Kronnos2006/smart-plant-bot/docs/entrega-final/Smart_Plant_Bot_Presentacion.pptx

Smart Plant Bot

Un sistema que cuida tus plantas automáticamente

Proyecto Final - Ingeniería Mecatrónica
Universidad INVENIO

## Slide 2

¿Por qué nuestras plantas mueren?

Las plantas de interior necesitan:

💧 Agua en la cantidad correcta (no mucha, no poca)

☀️ La cantidad adecuada de luz

🌡️ Temperatura y humedad estables

⏰ Atención constante y rutina

## Slide 3

¿Qué es Smart Plant Bot?

Es un pequeño sistema "inteligente" que:

✓ Riega la planta automáticamente cuando lo necesita

✓ Verifica que hay agua en el tanque

✓ Mide temperatura, humedad y luz del ambiente

✓ Todo sin que tengas que hacer nada

## Slide 4

¿Cómo funciona?

Proceso simple:

1️⃣ El sensor de humedad revisa la tierra

2️⃣ Si está muy seca, enciende la bomba

3️⃣ El agua sube desde el tanque a la maceta

4️⃣ Cuando hay humedad, apaga la bomba

5️⃣ El sistema mide la luz y temperatura

## Slide 5

Los "ojos y oídos" del sistema

Sensor de humedad de la tierra

Detecta si la tierra está seca o mojada

Sensor de nivel del tanque

Avisa si el agua se acabó

Sensor de temperatura y humedad

Mide el ambiente donde está la planta

Sensor de luz

Verifica si hay suficiente iluminación

## Slide 6

El "cerebro" del sistema

Arduino UNO

Es un pequeño microprocesador que:

📊 Recibe información de todos los sensores

🧠 Decide automáticamente cuándo regar

⚡ Controla la bomba de agua

⚙️ Todo basado en reglas lógicas y seguras

Tiene protecciones para que nada se dañe

## Slide 7

¿Por qué es útil?

🌱 Tus plantas siempre tienen el agua que necesitan

⏰ No depende de que recuerdes regarlas

💰 Evita gastar agua innecesariamente

📱 Puedes monitorear las condiciones del ambiente

🏠 Ideal para apartamentos y espacios pequeños

🎓 Sistema educativo: aprendes cómo funcionan los sistemas automáticos

## Slide 8

Smart Plant Bot

Plantas felices, sin preocupaciones

Un proyecto que combina:
Ingeniería • Electrónica • Programación • Sostenibilidad

¿Preguntas?
