Kronnos2006/smart-plant-bot/docs/entrega-final/Proyecto_Final_INV2026_corregido.docx

UNIVERSIDAD INVENIO

Facultad de Ingeniería

Ingeniería en Mecatrónica

Smart Plant Bot: sistema automatizado de cuidado de plantas mediante riego por humedad de suelo, supervisión del nivel del tanque y monitoreo de variables ambientales

Proyecto Final

Elaborado por:

Héctor José Caldera Alfaro — UI-SC-2025-47

Kensy Jimena Castro Vásquez — UI-SC-2024-87

José Mario Molina Herrera — UI-SC-2025-21

María Fernanda Porras Ruiz — UI-SC-2024-68

Guanacaste, septiembre de 2026

# Dedicatoria

A las familias que sostienen económica y emocionalmente la permanencia en la carrera, y que rara vez aparecen en los documentos que hacen posibles. A quienes cultivan plantas en balcones, cocinas y pasillos de apartamentos pequeños, porque de esa costumbre salió la pregunta que originó este proyecto.

# Agradecimientos

A la Universidad INVENIO, por el acceso a los laboratorios de la sede Los Ángeles de Tilarán y a las bases de datos académicas empleadas en la revisión de literatura.

Al cuerpo docente de la carrera, por las observaciones que obligaron a recortar el alcance del prototipo hasta dejarlo en algo que efectivamente se podía terminar y sustentar dentro del trimestre.

A las personas compañeras de la carrera que revisaron los avances y señalaron incoherencias entre el circuito simulado y el texto que lo describía, varias de las cuales habrían llegado sin corregir a la versión final.

# Resumen

El cuidado de plantas de interior en viviendas y aulas depende de una atención constante que las rutinas de trabajo y estudio interrumpen con frecuencia. La irregularidad del riego, el agotamiento del depósito y la falta de monitoreo de las condiciones ambientales pueden provocar riego excesivo o insuficiente, desperdicio de agua y operación inadecuada del sistema de bombeo. Por ello, el proyecto propone el Smart Plant Bot, un sistema electrónico de bajo costo para entornos domésticos y educativos de Costa Rica. El sistema, gobernado por un microcontrolador Arduino Uno, integra un sensor capacitivo de humedad de suelo para decidir el riego, un sensor de flotador para bloquear la bomba cuando el nivel del tanque es insuficiente y sensores DHT22 y BH1750 para medir temperatura, humedad relativa e iluminancia. La propuesta se fundamenta en mecánica de fluidos, electrostática, hidrostática, principio de Arquímedes, fotometría, física de semiconductores y modelado mediante ecuaciones diferenciales ordinarias de primer orden. La validación se realizó mediante simulación del circuito y de la lógica de control en Proteus, debido a que la construcción física quedó fuera del alcance temporal del trimestre. Los resultados verifican la lógica de umbral con histéresis, la inhibición del riego por nivel insuficiente y el comportamiento de la etapa de potencia con sus protecciones, estableciendo una base técnica para la construcción y validación física posterior del prototipo.

Palabras clave: riego automático, sensor capacitivo de humedad, supervisión de nivel, monitoreo ambiental, sistema mecatrónico.

# Índice General

# Índice De Tablas

# Índice De Figuras

# Capítulo 1: El Problema Y Su Propósito

Este capítulo delimita la dificultad técnica que dio origen al Smart Plant Bot y fija el propósito del trabajo. Comienza por el tema y su ubicación dentro de la Ingeniería Mecatrónica, describe la situación problemática con sus causas y consecuencias, revisa cuatro antecedentes que sitúan la propuesta dentro de una línea de investigación existente, formula las preguntas que orientan el estudio y cierra con la justificación, los objetivos, la viabilidad y las consecuencias esperadas de la intervención.

## 1.1. Tema De La Investigación

La automatización del cuidado de plantas a pequeña escala se ha vuelto una línea de trabajo habitual dentro de la Ingeniería Mecatrónica, sostenida por dos motivos que conviene separar. El primero es el interés por reducir el consumo de agua y de energía mediante sistemas embebidos de bajo costo. El segundo es didáctico: un prototipo de este tipo obliga a integrar mecánica de fluidos, electrostática, fotometría y física de los semiconductores en un mismo objeto, de modo que los principios estudiados en los cursos de física, matemática y circuitos dejan de ser enunciados de pizarra y pasan a tener consecuencias medibles sobre un circuito que funciona o no funciona.

El valor práctico se concreta en el prototipo Smart Plant Bot, gobernado por una placa Arduino Uno. El sistema decide el riego a partir de un sensor capacitivo de humedad de suelo, condiciona esa decisión a la existencia de reserva en el tanque y adquiere la temperatura, la humedad relativa y la iluminancia mediante sensores ambientales. El resultado es una solución replicable para espacios domésticos y educativos, construida con componentes disponibles en el mercado nacional y sin necesidad de supervisión humana continua.

Pese a la oferta creciente de dispositivos comerciales para el cuidado automatizado de plantas, sigue habiendo un vacío en la integración de estas tres funciones dentro de un mismo prototipo de arquitectura abierta y precio accesible. Ese vacío es el que el proyecto ocupa, y de paso permite desarrollar competencias en el diseño de sistemas mecatrónicos integradores, un área con demanda creciente en el mercado laboral costarricense.

## 1.2. Planteamiento Del Problema

El cuidado de plantas de interior en viviendas urbanas y en aulas depende de una atención sostenida que las rutinas de trabajo y los períodos de ausencia interrumpen con regularidad. El riego es la tarea más sensible a esa irregularidad, porque tanto la falta prolongada de agua como el exceso repetido dañan las raíces, y porque quien cultiva rara vez dispone de una referencia objetiva del contenido de agua del sustrato. En su lugar recurre a una estimación visual o táctil poco confiable, cuyo error no es simétrico: la tendencia dominante es a regar de más, por precaución.

A esa dificultad se suma el agotamiento del depósito. Un sistema que riega de forma autónoma pero no sabe cuánta agua le queda termina accionando la bomba en vacío, situación que desgasta el diafragma y que, además, priva al motor del enfriamiento que el propio flujo le proporciona. La consecuencia no es solo la pérdida de la planta, sino la del actuador.

El tercer aspecto es la ausencia de información sobre el entorno inmediato. La temperatura, la humedad relativa del aire y la iluminancia condicionan la velocidad con la que el sustrato pierde agua, de modo que desconocerlas impide interpretar el comportamiento observado. Las alternativas comerciales que sí registran esas magnitudes suelen exigir conexión permanente a una red de datos, requisito que encarece el equipo y ata su funcionamiento a la disponibilidad del servicio.

La convergencia de los tres aspectos configura una brecha clara entre lo que ocurre y lo que debería ocurrir. El riego se aplica según la agenda de la persona y no según la necesidad del sustrato; la reserva de agua se agota sin aviso; las condiciones ambientales quedan sin registrar. Ninguna de las tres decisiones relevantes se apoya en una medición.

De lo anterior se desprende la pregunta problema: ¿cuál es la viabilidad técnica y funcional de una maceta inteligente controlada por un microcontrolador Arduino, que integre el riego automático por humedad de suelo, la supervisión del nivel de agua del tanque y el monitoreo de variables ambientales, para el cuidado de plantas en entornos domésticos y educativos de Costa Rica durante el período 2026?

## 1.3. Antecedentes De La Investigación

Se revisaron cuatro trabajos publicados entre 2023 y 2025, localizados en las bases de datos ScienceDirect y Dialnet, procedentes de Estados Unidos, Indonesia, Ecuador y México. El criterio de selección fue su vínculo directo con la automatización del riego mediante humedad de suelo y con el monitoreo ambiental gobernado por microcontroladores de bajo costo, que son los dos ejes centrales del presente proyecto. Ninguno de los cuatro supera los cinco años de antigüedad. Se presentan en orden cronológico, del más antiguo al más reciente.

Bierer (2023), investigador del Servicio de Investigación Agrícola del Departamento de Agricultura de los Estados Unidos, con sede en Kearneysville, Virginia Occidental, publicó en la revista HardwareX el artículo titulado "Development of an open-source soil water potential management system for horticultural applications, Open_Irr", cuyo objetivo consistió en desarrollar una plataforma abierta y económica capaz de medir el estado hídrico del suelo y de ejecutar riegos de manera automática, sin exigir conocimientos de programación a la persona usuaria. El autor concluyó que el sistema cumplía ambas funciones a un costo competitivo frente a los equipos comerciales cerrados disponibles en el mercado hortícola.

En cuanto al enfoque, la investigación fue cuantitativa y de tipo aplicado, con un alcance validatorio centrado en el diseño, el ensamblaje y la prueba de un prototipo funcional. La unidad de análisis fue el propio prototipo y no un conjunto de personas, razón por la cual el estudio no reporta muestreo probabilístico ni población estadística. La validación se ejecutó durante abril de 2022 en un invernadero climatizado, sobre sesenta portainjertos de manzano distribuidos entre cinco nodos de medición y una puerta de enlace, con seiscientos cincuenta y cinco pares de lecturas contrastados frente a un lector comercial de referencia.

Este antecedente se relaciona de manera directa con el planteamiento del problema del presente proyecto, en tanto demuestra que un microcontrolador económico puede leer el estado hídrico del sustrato y accionar un actuador cuando la medición desciende por debajo de un umbral definido, que es exactamente el principio de funcionamiento de la maceta inteligente propuesta. La correspondencia alcanza incluso el nivel del componente, pues la etapa de potencia de Open_Irr emplea un transistor de efecto de campo FQP30N06 acompañado de una resistencia de polarización a tierra, topología que este proyecto retoma en su primer objetivo específico.

El aporte teórico de este antecedente reside en sustentar la relación entre el estado hídrico del sustrato y la decisión de riego, relación que constituye el fundamento del control por umbral desarrollado en el marco teórico. El aporte práctico consiste en demostrar que una arquitectura abierta y de bajo costo automatiza el riego sin depender de equipos comerciales cerrados, lo cual respalda la viabilidad económica de la propuesta. El aporte metodológico procede del procedimiento de contrastar las lecturas del prototipo frente a un instrumento de referencia y de cuantificar la concordancia obtenida, procedimiento replicable durante la fase de validación de este trabajo.

Setiawan et al. (2023), investigadores de la Universidad Bina Nusantara, con sede en Yakarta, Indonesia, publicaron en la revista Procedia Computer Science el artículo titulado "Smart Plant Watering and Lighting System to Enhance Plant Growth Using Internet of Things", cuyo objetivo consistió en proponer un sistema inteligente de cuidado vegetal que integrara el riego y la iluminación complementaria mediante sensores conectados a una placa Arduino. Los autores concluyeron que el riego decidido a partir de la humedad del sustrato y de la intensidad lumínica operó de forma automática y sostenida durante todo el período de ensayo, sin requerir intervención manual.

Metodológicamente, el estudio correspondió a un desarrollo experimental de enfoque cuantitativo y de tipo aplicado, con un alcance comparativo, dividido en una fase de diseño de hardware y otra de diseño de software. La unidad de análisis estuvo constituida por el prototipo junto con las plantas cultivadas, de modo que no se aplicó muestreo probabilístico ni se definió una población estadística. Durante cuatro semanas se compararon las alturas alcanzadas por dos especies vegetales sometidas a riego automático y a riego manual, y se registraron de forma tabulada el contenido de agua del suelo, la intensidad lumínica y el estado de los actuadores.

La relación de este antecedente con los objetivos específicos del presente proyecto es directa, puesto que demuestra que una sola placa Arduino puede integrar la lectura simultánea de temperatura, humedad relativa, humedad de suelo e intensidad lumínica, que son precisamente las variables contempladas en el segundo objetivo específico de diagnóstico. El estudio emplea además un sensor equivalente al DHT22 seleccionado para esta propuesta y fija un umbral de humedad de suelo del sesenta por ciento para accionar la bomba, criterio que orienta la definición preliminar de los umbrales de activación del prototipo.

El aporte teórico de este trabajo consiste en fundamentar los rangos favorables para el crecimiento vegetal, con una temperatura comprendida entre quince y treinta grados Celsius y una humedad relativa situada entre sesenta y ochenta por ciento, valores que el presente proyecto adopta como referencia de interpretación. El aporte práctico se evidencia en la mayor altura alcanzada por las plantas bajo riego automatizado frente al manual. El aporte metodológico proviene del registro tabulado y periódico de las lecturas de sensores y del estado de los actuadores, formato que este proyecto reproduce durante la verificación funcional del sistema.

Potosí Carvajal et al. (2024), investigadores de la Universidad Laica Eloy Alfaro de Manabí, sede El Carmen, Ecuador, publicaron en la Revista Ciencia UNEMI el artículo titulado "Sistema de tiempo real para el riego en la finca Carmen Torres", cuyo objetivo consistió en elaborar y optimizar un sistema de riego automatizado en tiempo real para el cultivo de plátano, gobernado por un microcontrolador ESP32 y supervisado desde un sitio web que mostraba la humedad del suelo. Los autores concluyeron que la automatización redujo de manera apreciable las labores manuales de la finca, sin representar un costo elevado para la unidad productiva.

El estudio adoptó un enfoque cualitativo y un tipo de investigación aplicada, apoyado en el método analítico-sintético, con un alcance descriptivo centrado en diseñar y probar un prototipo dentro de un caso real. La población estuvo integrada por las personas trabajadoras de la finca, de las cuales se consultaron dos mediante entrevista: una perteneciente al personal administrativo y otra encargada directamente del riego. El muestreo fue de tipo no probabilístico e intencional, y se emplearon como técnicas la entrevista, la observación sistemática y una lista de cotejo destinada a verificar la infraestructura disponible.

Este antecedente se vincula sobre todo con la justificación del presente proyecto, dado que documenta un beneficio concreto y verificable para quienes ejecutaban el riego de forma manual: la liberación de una tarea repetitiva que interrumpía el resto de sus actividades cotidianas. El costo total del sistema, cercano a ciento noventa dólares estadounidenses, confirma que este tipo de solución se mantiene dentro de un intervalo económicamente accesible, argumento que sostiene tanto la relevancia social como la viabilidad declaradas para la maceta inteligente en los apartados siguientes de este capítulo.

El aporte teórico reside en el concepto de sistema en tiempo real aplicado al riego, según el cual una respuesta tardía pierde utilidad práctica, lo que justifica el muestreo continuo de las variables adoptado en esta propuesta. El aporte práctico consiste en demostrar que una placa de bajo costo gobierna una bomba mediante una etapa de conmutación sencilla, sin recurrir a controladores industriales. El aporte metodológico corresponde al empleo de una lista de cotejo para verificar la presencia y el estado de los componentes, instrumento que este proyecto adapta bajo la forma de la ficha de registro técnico descrita en el marco metodológico.

Jiménez (2025), investigador del Instituto Tecnológico Superior de Escárcega, ubicado en Campeche, México, publicó en Latam: Revista Latinoamericana de Ciencias Sociales y Humanidades el artículo titulado "Automatización del riego en un invernadero para cultivo de hortalizas de traspatio", cuyo objetivo consistió en desarrollar y evaluar un sistema automatizado con Arduino y sensores de humedad para optimizar el consumo de agua y mejorar el rendimiento frente al método tradicional. El autor concluyó que la automatización favorece una agricultura más eficiente y económicamente viable para las personas productoras de pequeña escala.

La investigación fue de tipo aplicada, con enfoque cuantitativo y diseño experimental, sustentada en la comparación entre dos áreas de cultivo de características similares sometidas a manejos distintos. La unidad de análisis estuvo constituida por dichas áreas de cultivo y no por un conjunto de personas, razón por la cual el estudio no reporta muestreo probabilístico ni población estadística. El alcance fue comparativo y se extendió durante treinta días, período en el que se midieron el consumo de agua, la frecuencia y la duración de cada riego, el crecimiento vegetal alcanzado y el tiempo dedicado a la supervisión del cultivo.

La relación de este antecedente con el primer objetivo específico del presente proyecto es directa, puesto que demuestra que un umbral de humedad definido distribuye el agua de manera más uniforme a lo largo del sustrato que el riego aplicado según el criterio de la persona cuidadora. La escala de traspatio en la que se desarrolló el estudio coincide además con los ámbitos doméstico y educativo delimitados en el planteamiento del problema de este trabajo, lo que refuerza la pertinencia de sostener el enfoque de pequeña escala frente a soluciones concebidas para agricultura extensiva.

El aporte teórico de este antecedente consiste en relacionar la uniformidad de la humedad del sustrato con el desarrollo vegetal alcanzado, relación que fundamenta la conveniencia del control por umbral frente al riego programado por tiempo. El aporte práctico se refleja en el ahorro de agua del treinta y cinco por ciento registrado y en la reducción a la mitad del tiempo dedicado a la supervisión del cultivo. El aporte metodológico corresponde al diseño comparativo entre el manejo automatizado y el tradicional, esquema que este proyecto podría replicar en una fase posterior de validación con el prototipo ya construido.

Los cuatro antecedentes revisados, procedentes de instituciones de Estados Unidos, Indonesia, Ecuador y México y publicados entre 2023 y 2025, describen en conjunto una línea de desarrollo tecnológico coherente. Bierer (2023) establece que una plataforma abierta y económica basta para automatizar el riego mediante umbrales de humedad de suelo. Setiawan et al. (2023) amplían ese alcance hacia el monitoreo simultáneo de temperatura, humedad relativa e iluminancia. Potosí Carvajal et al. (2024) trasladan el control en tiempo real a un caso productivo con costo verificado, y Jiménez (2025) cierra la línea comparando el manejo automatizado frente al manual y cuantificando el ahorro hídrico obtenido.

La escogencia de estos cuatro trabajos responde a que cada uno respalda un componente distinto de la presente propuesta: Bierer confirma la viabilidad técnica del riego por umbral y aporta la topología de la etapa de potencia; Setiawan et al. sustentan el diagnóstico de las variables ambientales y sus rangos de referencia; Potosí Carvajal et al. respaldan el beneficio social y el costo accesible; y Jiménez ofrece el criterio de comparación frente al manejo manual. Ninguno de los cuatro incorpora, sin embargo, la supervisión del nivel del depósito como condición que habilita el riego, y ese es precisamente el vacío que el Smart Plant Bot busca ocupar.

## 1.4. Preguntas De Investigación

Actualmente el cuidado de las plantas de interior en espacios domésticos y educativos se realiza, en la mayoría de los casos, de manera manual e intuitiva, sin herramientas que permitan medir de forma objetiva las variables que determinan su desarrollo, como la humedad del suelo, la luz que recibe o la temperatura del ambiente. Esa situación provoca que las decisiones sobre el riego y sobre la evaluación general del estado de la planta dependan casi por completo de la percepción de la persona cuidadora, lo cual aumenta la probabilidad de errores en el manejo cotidiano.

Entre las causas principales de esta situación se encuentra la falta de tiempo y de conocimientos técnicos de las personas encargadas del cuidado, quienes generalmente no cuentan con la disponibilidad necesaria para vigilar de forma constante las condiciones del ambiente ni para revisar de manera periódica cuánta agua queda en el depósito. A esto se suma el desconocimiento generalizado sobre los rangos adecuados de humedad, de luz y de nutrientes que requiere cada tipo de planta, lo cual conduce con frecuencia a prácticas de riego excesivo o insuficiente.

Otra causa relevante se relaciona con la oferta actual de dispositivos comerciales para el cuidado automatizado de plantas, que tiende a concentrarse en una sola función específica, ya sea el riego o la iluminación, sin integrar dentro de un mismo sistema el monitoreo de las condiciones del ambiente junto con la vigilancia de la reserva de agua disponible. A esto se agrega que los productos que sí reúnen varias funciones suelen tener un precio elevado, lo cual limita su acceso al estudiantado, a las personas aficionadas a la jardinería y a quienes disponen de recursos económicos moderados.

Como consecuencia de lo anterior, resulta común observar una alta tasa de deterioro o de muerte de plantas de interior, así como un uso ineficiente del agua destinada al riego, producto de decisiones basadas en la apreciación de la persona y no en mediciones reales de las condiciones del suelo y del ambiente. Esta situación no solo afecta el bienestar de las plantas, sino que además representa una oportunidad desaprovechada para desarrollar competencias tecnológicas dentro de la población estudiantil vinculada a la carrera de Ingeniería Mecatrónica.

De sostenerse esta situación sin ninguna intervención, es previsible que el cuidado de las plantas continúe dependiendo del criterio y del tiempo disponible de las personas cuidadoras, lo cual mantendrá elevadas tanto las tasas de pérdida de plantas como el desperdicio de agua en los hogares y en los espacios educativos donde se practica la jardinería de manera informal. A mediano plazo se dificultará además que el estudiantado relacione los contenidos de física con problemas cotidianos mediante un sistema que pueda medirse y observarse de forma directa.

Asimismo, si no se desarrollan alternativas tecnológicas accesibles, se mantendrá la dependencia respecto de dispositivos comerciales importados y de costo elevado, lo cual restringe el acceso de la población estudiantil y de las personas con recursos limitados a soluciones integrales de automatización. Esa dependencia retrasa además el desarrollo de capacidades locales en el diseño de sistemas mecatrónicos para la agricultura urbana, así como la posibilidad de construir prototipos propios, documentados, reparables y adaptados a las condiciones específicas de Costa Rica.

El presente proyecto se limita al contexto de los espacios domésticos y educativos costarricenses, y contempla como caso piloto su implementación dentro de los laboratorios de la Universidad INVENIO, sede Los Ángeles de Tilarán, desde donde se proyecta como una solución replicable en hogares, oficinas y pequeños proyectos de jardinería educativa de la región.

Con base en lo anterior, las preguntas que orientan la investigación se derivan de manera directa de los objetivos específicos formulados en el apartado 1.6.2 y se enuncian de la siguiente manera:

- ¿Cuáles son los requerimientos técnicos y funcionales del riego automático por humedad de suelo y de la supervisión del nivel de agua del tanque, incluyendo los parámetros de riego, la configuración de sensores de nivel y las condiciones de seguridad eléctrica de la conmutación?
- ¿Qué variables del ambiente resultan más relevantes para estimar el bienestar de la planta y con qué sensores conviene medirlas?
- ¿Cómo debe diseñarse la arquitectura funcional, eléctrica y mecánica que integre los tres subsistemas sobre una misma plataforma de control?
- ¿De qué manera puede validarse el funcionamiento del prototipo dentro de los límites de tiempo del trimestre académico?

## 1.5. Justificación De La Investigación

La propuesta ofrece una solución integral, replicable y de bajo costo para el cuidado de plantas en espacios domésticos y educativos. A diferencia de los dispositivos comerciales, que se concentran en el riego o en la iluminación, integra el riego por humedad de suelo, la vigilancia del nivel de agua y el monitoreo del ambiente, lo cual amplía tanto su utilidad práctica como su valor pedagógico para el estudiantado de Ingeniería Mecatrónica.

La automatización del riego a partir de una medición directa del sustrato sustituye una apreciación subjetiva por un criterio que puede cuantificarse, y la entrega de agua en eventos de duración acotada limita el consumo frente a la aplicación manual, habitualmente generosa por precaución. La vigilancia del depósito no es un agregado informativo: cumple una función de protección del actuador, ya que impide que la bomba trabaje en seco.

La decisión de mantener el control principal de forma local es un criterio de diseño deliberado y no una carencia. La lógica de riego no depende de una red, de un servicio contratado ni de credenciales de acceso, con la reducción de costo y de puntos de falla que eso implica. El conjunto sigue operando con normalidad ante cualquier interrupción del servicio de comunicaciones de la vivienda.

En cuanto a relevancia social, el proyecto beneficia a estudiantes, a personas aficionadas a la jardinería y a usuarios domésticos con poco tiempo. Las instituciones educativas pueden emplearlo como recurso didáctico para aplicar física, electrónica y programación a la agricultura urbana. Y en cuanto a trascendencia, la propuesta sienta bases para desarrollos posteriores dentro de la carrera, orientados a la agricultura urbana automatizada y al fortalecimiento de competencias en Internet de las Cosas aplicado a la física y la electrónica.

## 1.6. Objetivo General Y Objetivos Específicos

### 1.6.1. Objetivo General

Desarrollar un sistema electrónico de riego y monitoreo de plantas (Smart Plant Bot), integrando un sensor capacitivo de humedad de suelo, un sensor de nivel de agua y sensores ambientales sobre un microcontrolador Arduino Uno, optimizando el uso del agua y facilitando el monitoreo de las condiciones de la planta, en entornos domésticos y educativos de Costa Rica, por parte del equipo de estudiantes de Ingeniería Mecatrónica de la Universidad INVENIO.

### 1.6.2. Objetivos Específicos

Los cuatro objetivos guardan un orden cronológico y se derivan de manera directa del objetivo general. El primero integra el diagnóstico del riego automático y de la supervisión del nivel de agua; el segundo aborda el monitoreo ambiental; el tercero articula los elementos en una arquitectura común y el cuarto somete el conjunto a verificación.

- Identificar los requerimientos técnicos y funcionales del riego automático por humedad de suelo y de la supervisión del nivel de agua del tanque, incluyendo el intervalo de humedad admisible, el volumen y caudal del riego, la configuración de sensores para el nivel del depósito y las condiciones de seguridad eléctrica de la conmutación.
- Analizar las variables ambientales de temperatura, humedad relativa e iluminancia más relevantes para la estimación del bienestar de la planta, seleccionando los sensores conforme a su exactitud declarada, definiendo la frecuencia de medición de cada magnitud y estableciendo los intervalos de referencia con los que la persona usuaria contrasta los valores presentados.
- Diseñar la arquitectura funcional, eléctrica y mecánica del prototipo que integre los subsistemas de riego, de supervisión del nivel y de monitoreo ambiental, resolviendo la asignación de terminales, el reparto de la energía entre etapas de consumo dispar, la separación entre el circuito de control y el de potencia, y la geometría de la carcasa que aloja los componentes.
- Validar el funcionamiento del prototipo mediante la simulación del circuito y de la lógica de control en el entorno Proteus, verificando la respuesta ante variaciones de humedad de suelo, el bloqueo del riego por nivel insuficiente y el comportamiento de las protecciones de la etapa de potencia.

## 1.7. Viabilidad

La viabilidad se sustenta en el acceso real del equipo a los componentes requeridos. El microcontrolador Arduino, los sensores de humedad de suelo, de nivel de agua, de temperatura y humedad relativa y de iluminancia, así como la bomba de baja tensión, se consiguen en el mercado nacional a precios accesibles. El plan de estudios asigna tiempo curricular para el desarrollo, la documentación y la verificación, y el proyecto cuenta con el acompañamiento del cuerpo docente y con acceso a los laboratorios de la Universidad INVENIO. La información técnica sobre el comportamiento de sensores y actuadores es de libre acceso en manuales y hojas de datos de los fabricantes, lo cual facilita el diagnóstico y el diseño.

## 1.8. Consecuencias De La Investigación

Una vez implementada, la propuesta debería reducir el desperdicio de agua en el riego doméstico, porque la bomba se activa únicamente cuando la humedad del sustrato cae por debajo del umbral definido y solo si hay reserva disponible. Cabe esperar también una mejora en la salud y el desarrollo de las plantas, derivada de la vigilancia constante del agua y del monitoreo continuo del entorno.

En el plano académico, el trabajo puede servir de base para desarrollos posteriores dentro de la carrera, orientados a sistemas de agricultura urbana automatizada de mayor escala. Y tiene un efecto formativo sobre el estudiantado, al obligar a aplicar conocimientos de física, electrónica, matemática y programación a un problema cotidiano cuyo resultado se verifica de manera inmediata.

# Capítulo 2: Marco Teórico

Este capítulo desarrolla los fundamentos físicos, matemáticos y electrónicos que sustentan cada subsistema del prototipo. Los tres primeros temas desarrollan los fundamentos de los subsistemas de diagnóstico: riego automático, supervisión del nivel del tanque y monitoreo ambiental; el primer objetivo específico integra los dos primeros dentro de un mismo requerimiento funcional. Los tres últimos aportan las herramientas transversales que ninguno de los subsistemas puede prescindir: el modelado dinámico mediante ecuaciones diferenciales, el acondicionamiento analógico de las señales y el diseño mecánico de la estructura que aloja el conjunto.

Conviene una advertencia sobre el uso de las expresiones que siguen. Las ecuaciones se presentan con las variables definidas y con las hipótesis bajo las cuales son válidas, porque en un prototipo de bajo costo el error más frecuente no es equivocarse en la aritmética sino aplicar una relación fuera del régimen en que fue deducida. Los valores numéricos que aparecen corresponden a datos nominales de hojas de datos o a resultados de la simulación, y se identifican como tales en cada caso.

## 2.1. Sistemas De Riego Automático Basados En Sensores De Humedad De Suelo

El riego automático reúne tres procesos de naturaleza distinta: el transporte de un fluido incompresible desde el depósito hasta la zona radicular, la medición indirecta de una propiedad del sustrato y la ejecución de una decisión de control sobre un actuador. El desempeño del conjunto no depende de ninguno de ellos por separado, sino de la coherencia entre la medición, la decisión y la acción.

Campos et al. (2021) desarrollaron una plataforma abierta de bajo costo que automatiza el riego mediante sensores de humedad y un microcontrolador Arduino Mega 2560, evaluada bajo cuatro umbrales distintos de contenido volumétrico de agua. Jain (2023) y Pramanik et al. (2022) resolvieron el mismo problema integrando sensores, controlador y bombas dentro de arquitecturas comparables. Estos tres trabajos muestran que una instalación de pequeña escala sostiene el riego automático siempre que la medición, el control y el accionamiento se diseñen de forma conjunta.

El tema se desarrolla en cuatro subtemas que siguen el recorrido físico del agua y de la señal: 2.1.1. Principios de mecánica de fluidos y comportamiento de la bomba de diafragma; 2.1.2. Medición y calibración de la humedad del suelo mediante sensores capacitivos; 2.1.3. Conmutación electrónica y accionamiento de la bomba de corriente continua; y 2.1.4. Control por umbral con histéresis. El primero explica cómo se desplaza el agua, el segundo cómo se mide el estado del sustrato, el tercero cómo se acciona el actuador y el cuarto cómo se decide cuándo hacerlo.

### 2.1.1. Principios De Mecánica De Fluidos Y Comportamiento De La Bomba De Diafragma

El riego doméstico puede describirse como el transporte de un volumen determinado de agua desde un depósito hasta la zona radicular, proceso regido por las leyes de conservación de la masa y de la energía aplicadas a los fluidos (Cengel y Cimbala, 2006). Las magnitudes que intervienen son la presión, el caudal volumétrico, la velocidad media del flujo y la altura geométrica que debe vencerse. Caracterizarlas permite dimensionar el elemento impulsor y la sección de la conducción de modo que el volumen entregado por evento sea previsible.

La ecuación de continuidad expresa que, en un flujo estacionario e incompresible, el caudal volumétrico permanece constante a lo largo de un tubo de corriente:

Q = A1v1 = A2v2 = constante | (1)

donde:

Q : caudal volumétrico (m³/s)

A : área de la sección transversal (m²)

v : velocidad media del flujo en esa sección (m/s)

De la ecuación (1) se sigue que reducir el diámetro de la manguera incrementa la velocidad del agua en proporción inversa al cuadrado del diámetro, con el consiguiente aumento de las pérdidas por fricción. Como el volumen aplicado resulta del producto del caudal por el tiempo de accionamiento, la relación permite estimar la duración de cada evento de riego sin recurrir a un caudalímetro.

La ecuación de Bernoulli establece la conservación de la energía mecánica por unidad de peso a lo largo de una línea de corriente, bajo los supuestos de flujo estacionario, incompresible y sin fricción. En una instalación real esos supuestos se cumplen solo de forma aproximada, por lo que corresponde emplear la formulación extendida, que incorpora la energía aportada por la bomba y la disipada por efectos viscosos (Cengel y Cimbala, 2006):

(p1 / ρg) + (v1² / 2g) + z1 + hb = (p2 / ρg) + (v2² / 2g) + z2 + hL | (2)

donde:

p : presión estática (Pa)

ρ : densidad del agua, 998 kg/m³ a 20 °C

g : aceleración de la gravedad, 9,81 m/s²

z : altura geométrica respecto del nivel de referencia (m)

hb : altura útil aportada por la bomba (m)

hL : pérdida de carga total del circuito (m)

El término hL agrupa las pérdidas primarias, distribuidas a lo largo de los tramos rectos, y las secundarias, concentradas en codos, uniones y filtros. Las primeras se cuantifican mediante la ecuación de Darcy-Weisbach:

hL = f · (L / D) · (v² / 2g) | (3)

donde:

f : factor de fricción de Darcy (adimensional)

L : longitud de la conducción (m)

D : diámetro interno (m)

El factor f depende del número de Reynolds y de la rugosidad relativa. El número de Reynolds compara las fuerzas de inercia con las viscosas y determina el régimen del flujo:

Re = ρvD / μ = vD / ν | (4)

donde:

μ : viscosidad dinámica del agua, 1,00 × 10⁻³ Pa·s a 20 °C

ν : viscosidad cinemática, 1,00 × 10⁻⁶ m²/s a 20 °C

En el circuito hidráulico del prototipo, con una manguera de diámetro interno del orden de cuatro milímetros y un caudal nominal de bomba cercano a dos litros por minuto, la velocidad media resulta próxima a 2,7 m/s y el número de Reynolds queda en torno a 1,1 × 10⁴. Ese valor sitúa el flujo en régimen turbulento liso, no laminar, corrección importante respecto de la suposición habitual en sistemas de bajo caudal. Para régimen laminar, en cambio, el factor de fricción se obtiene directamente de:

f = 64 / Re (válida solo para Re < 2300) | (5)

Las pérdidas secundarias se calculan mediante coeficientes adimensionales asociados a cada accesorio:

hL,menores = Σ KL · (v² / 2g) | (6)

En circuitos cortos como el del Smart Plant Bot, la suma de las pérdidas secundarias llega a superar a la de los tramos rectos, de modo que omitirlas conduce a sobrestimar el caudal entregado. Xu et al. (2022) analizaron precisamente el flujo y la disipación de energía en el interior de un emisor de riego por goteo, y Hou et al. (2024) representaron la dependencia entre caudal y presión de operación mediante una expresión potencial:

q = K H^x | (7)

donde:

q : caudal del emisor (L/h)

H : presión de operación (m.c.a.)

K, x : parámetros propios del emisor, obtenidos experimentalmente

El exponente x indica el grado de compensación de presión del emisor: valores próximos a 0,5 corresponden a orificios sin compensación y valores cercanos a cero, a emisores autocompensantes. Gao et al. (2023) construyeron sobre esta base un modelo para predecir los elementos hidráulicos de un sistema de riego por goteo con válvulas de descarga automática, y Campos et al. (2021) trasladaron ese criterio a una plataforma de bajo costo gobernada por microcontrolador.

La potencia hidráulica útil que la bomba debe entregar se obtiene de:

Phid = ρg Q hb ; η = Phid / Peléctrica | (8)

Aplicados al prototipo, estos principios señalan tres condiciones que el diseño debe atender. La manguera de pequeño diámetro impone una sección reducida y, por continuidad, velocidades altas con mayor disipación. La diferencia de altura entre el tanque y la superficie del sustrato representa una energía potencial que la bomba debe vencer. Y la bomba de doce voltios dispone de una potencia eléctrica limitada para ambas tareas, de modo que el caudal real quedará por debajo del nominal declarado por el fabricante. La comprobación experimental del volumen descargado en un intervalo conocido permite contrastar el comportamiento real con el previsto durante el diseño.

Corresponde ahora examinar el elemento que impulsa ese caudal. La bomba empleada es de diafragma: una membrana flexible modifica de forma periódica el volumen de la cámara de bombeo, y los cambios de presión que ese movimiento genera desplazan el fluido, mientras que las válvulas de entrada y de salida lo obligan a circular en un solo sentido (Hu et al., 2026). El caudal entregado depende de manera directa de la deflexión de la membrana (Mohith et al., 2022; Tripathi et al., 2023), de modo que el volumen desplazado por ciclo puede aproximarse como el producto del área efectiva del diafragma por su desplazamiento medio:

Q = Vciclo · fciclo · ηvol , con Vciclo ≈ Aef · δ | (9)

donde:

Vciclo : volumen desplazado por ciclo (m³)

fciclo : frecuencia de accionamiento del diafragma (Hz)

ηvol : eficiencia volumétrica, que descuenta el reflujo por las válvulas

δ : deflexión media de la membrana (m)

Mientras el material trabaje dentro de su régimen elástico y las deformaciones sean pequeñas, la relación entre esfuerzo y deformación admite la aproximación lineal de la ley de Hooke (Li y Masen, 2024):

σ = E ε , ε = ΔL / L0 | (10)

donde:

σ : esfuerzo normal (Pa)

E : módulo de elasticidad o módulo de Young del material (Pa)

ε : deformación unitaria (adimensional)

La consecuencia práctica es que la bomba entrega un caudal aproximadamente constante mientras la membrana no supere su límite elástico. Superado ese punto, la deformación deja de ser proporcional al esfuerzo, la deflexión por ciclo se reduce y el caudal cae de forma progresiva. Ese es el mecanismo físico del desgaste que produce la operación en seco, y la razón por la que la supervisión del nivel del tanque cumple una función de protección y no solo informativa.

### 2.1.2. Medición Y Calibración De La Humedad Del Suelo Mediante Sensores Capacitivos

El sensor de humedad del prototipo se fundamenta en la relación entre la capacitancia y la permitividad del medio. Para una geometría de placas paralelas, la capacitancia responde a:

C = ε0 εr A / d | (11)

donde:

C : capacitancia (F)

ε0 : permitividad del vacío, 8,854 × 10⁻¹² F/m

εr : permitividad relativa del medio entre electrodos (adimensional)

A : área enfrentada de los electrodos (m²)

d : separación entre electrodos (m)

En el sustrato conviven aire, partículas sólidas y agua, cuyas permitividades relativas difieren de forma notable. Deng et al. (2021) reportan valores cercanos a 80 para el agua, de 1 para el aire y entre 2 y 9 para las partículas minerales. Dado que la geometría del sensor permanece fija, cualquier variación del contenido de agua modifica la permitividad efectiva del conjunto y, con ella, la capacitancia. Un modelo de mezcla de uso corriente pondera las tres fases según su fracción volumétrica:

εef1/2 = θ εagua1/2 + (1 − φ) εsólido1/2 + (φ − θ) εaire1/2 | (12)

donde:

θ : contenido volumétrico de agua (m³/m³)

φ : porosidad del sustrato (m³/m³)

El sensor incorpora un oscilador cuya frecuencia depende del valor capacitivo, seguido de una etapa de rectificación y filtrado que entrega una tensión continua. Esa arquitectura mantiene las pistas del electrodo recubiertas por una capa aislante, de manera que no hay contacto galvánico entre el circuito y la solución del sustrato, lo que evita la degradación electroquímica que limita de forma severa la vida útil de las alternativas resistivas. Zaccarin et al. (2025) describen la relación entre la permitividad del medio, la capacitancia del sensor y la frecuencia de resonancia del circuito, que se desplaza al cambiar el contenido de agua, y evalúan sensores fabricados sobre sustrato biodegradable a distintas profundidades frente a un dispositivo comercial.

La respuesta no está exenta de fuentes de error. La temperatura del sustrato modifica la permitividad del agua e introduce una deriva a lo largo del ciclo diario. La salinidad de la solución y la densidad aparente del sustrato alteran la relación entre señal y contenido volumétrico, razón por la cual las curvas provistas por el fabricante tienen validez limitada. Y la profundidad de inserción condiciona qué volumen de sustrato queda efectivamente representado en la lectura.

Por todo lo anterior, la lectura solo adquiere significado tras una calibración. El procedimiento más frecuente registra la señal en dos condiciones extremas —el sensor expuesto al aire y el sensor inmerso en sustrato saturado— y establece entre ambas una interpolación lineal:

θest = (Saire − S) / (Saire − Ssat) · θsat | (13)

donde:

S : lectura del convertidor analógico digital en el instante considerado

Saire, Ssat : lecturas en aire y en sustrato saturado

θsat : contenido volumétrico a saturación, próximo a la porosidad del sustrato

La linealidad de la ecuación (13) es una simplificación admisible dentro del intervalo de trabajo, pero no en toda la escala. Verma y Pahuja (2021) relacionaron las señales de varios sensores con valores de referencia del contenido de agua mediante modelos de regresión y redes neuronales, y obtuvieron ajustes claramente superiores a los de una recta. Pahuja (2022) desarrolló además un sistema semiautomático de recalibración con modelos de ajuste para representar la respuesta de sensores inteligentes de humedad. Un ajuste polinómico de segundo grado suele bastar para el intervalo de interés:

θest = a2S² + a1S + a0 , con R² evaluado sobre el conjunto de calibración | (14)

El corolario para el prototipo es directo: la señal del sensor capacitivo debe relacionarse experimentalmente con las condiciones reales del sustrato antes de emplearla como entrada de control. Solo entonces los límites de humedad que activan o detienen la bomba corresponden a un contenido de agua conocido y no a un número arbitrario del convertidor.

### 2.1.3. Conmutación Electrónica Y Accionamiento De La Bomba De Corriente Continua

El accionamiento de la bomba involucra dos fenómenos electromagnéticos estudiados en el curso. El primero es el comportamiento inductivo del motor: al circular corriente por sus devanados se almacena energía en un campo magnético, y si esa corriente se interrumpe de forma brusca la inductancia induce una tensión de sentido contrario capaz de superar la de alimentación y de destruir el elemento de conmutación. Ese es el motivo físico del diodo colocado en antiparalelo con la carga, cuyo transitorio se analiza en detalle en el apartado 2.4.2.

El segundo fenómeno es el comportamiento del transistor de efecto de campo como interruptor. La tensión aplicada entre puerta y fuente controla la conducción entre drenador y surtidor, de modo que una señal de baja potencia habilita o corta una corriente muy superior. Cuando VGS supera con holgura la tensión de umbral y la caída drenador-fuente es pequeña, el dispositivo opera en región óhmica y se comporta como una resistencia:

VDS = ID · RDS(on) , con VGS ≫ VGS(th) | (15)

La potencia disipada en conducción se obtiene de forma inmediata:

Pcond = ID² · RDS(on) · D | (16)

donde:

ID : corriente de drenador, igual a la corriente de la bomba (A)

RDS(on) : resistencia de conducción declarada para la VGS efectivamente aplicada (Ω)

D : ciclo de trabajo, fracción del tiempo en que el transistor conduce

Aquí aparece el error de selección más común en prototipos alimentados a cinco voltios. Muchos transistores de esta familia especifican su RDS(on) para VGS de diez voltios, valor que la salida digital del microcontrolador nunca alcanza. Con cinco voltios en la puerta, la resistencia real puede duplicarse o triplicarse respecto de la declarada, con el consiguiente aumento cuadrático de la disipación. Bierer (2023) resolvió esta etapa con un FQP30N06 acompañado de una resistencia de polarización a tierra y un diodo 1N4007, mientras que Campos et al. (2021) optaron por controladores de relé accionados según las condiciones determinadas por el sistema. La verificación térmica se realiza mediante la resistencia térmica unión-ambiente:

Tj = Ta + Pdisipada · RθJA | (17)

La etapa de potencia exige además adecuar la alimentación de cada elemento. Jain (2023) integró una bomba sumergible de corriente continua, un módulo de relés y una fuente de baja tensión, lo que evidencia la necesidad de un elemento de conmutación entre el controlador y el actuador. Pramanik et al. (2022) incorporaron un convertidor LM2596 para adecuar la alimentación de los componentes de su sistema de riego. En el Smart Plant Bot la energía se reparte entre los cinco voltios del microcontrolador y los sensores, y los doce voltios de la bomba, con referencia común obligatoria entre ambos dominios.

La separación entre control y potencia no es una preferencia de estilo. Sin ella, las salidas digitales quedarían expuestas a corrientes que exceden su capacidad, y el escalón de corriente que produce el arranque del motor alcanzaría directamente al circuito de medición.

### 2.1.4. Control Por Umbral Con Histéresis

El control por umbral transforma una medición física en una decisión automática, aunque antes debe mediar una conversión. La señal del sensor es analógica y varía de forma continua, mientras que el microcontrolador solo opera con valores discretos, de modo que su convertidor asigna a cada tensión un número entero dentro de un intervalo definido, según se detalla en el apartado 2.5.4. Sobre ese valor numérico se fijan los límites de referencia.

La formulación más simple compara la lectura con un valor único. Campos et al. (2021) evaluaron cuatro umbrales distintos de contenido volumétrico de agua y comprobaron que el sistema aplicaba el riego de forma confiable en todos ellos, y Pramanik et al. (2022) obtuvieron resultados equivalentes vinculando las lecturas de humedad con la apertura y el cierre del suministro. Un umbral único, sin embargo, produce conmutaciones repetidas cuando la señal oscila alrededor del punto de disparo. La solución es separar el umbral de activación del de desactivación:

bomba = 1 si θ < θON ; bomba = 0 si θ > θOFF ; con θOFF > θON | (18)

La diferencia θOFF − θON constituye la banda de histéresis, y su valor debe superar el ruido de la medición para cumplir su función. El apartado 2.5.3 desarrolla el equivalente analógico de esta lógica, cuyo dimensionamiento sigue exactamente el mismo razonamiento.

La estrategia admite condiciones adicionales. Bierer (2023) incorpora parámetros configurables que incluyen, además del umbral, un intervalo mínimo entre eventos y una duración determinada para cada riego, criterios que evitan activaciones sucesivas antes de que el agua alcance la zona radicular. Jain (2023) integró de manera semejante las lecturas de varios sensores en la decisión de accionamiento. En el Smart Plant Bot esos criterios temporales se combinan con la disponibilidad de agua en el tanque, según la lógica que desarrolla el apartado 2.2.4.

## 2.2. Supervisión Del Nivel De Agua Del Tanque

La supervisión del depósito es el segundo eje funcional del prototipo y responde al objetivo de determinar la configuración de sensores y la lógica necesaria para verificar la reserva disponible. Requiere comprender cómo se relaciona la altura de una columna de líquido con la presión que ejerce en el fondo, qué principio permite que un cuerpo flote y de qué manera esa información se convierte en una condición que habilita o impide el funcionamiento de la bomba.

El tema se desarrolla en cuatro subtemas encadenados: 2.2.1. Principios físicos de la medición de nivel de líquidos; 2.2.2. Comparación de tecnologías de sensado de nivel; 2.2.3. Lectura digital del sensor y acondicionamiento de la señal; y 2.2.4. Lógica de decisión combinada entre humedad de suelo y nivel de agua. Los dos primeros justifican la elección del principio de medición, el tercero resuelve su lectura y el cuarto la incorpora a la decisión de riego establecida en el tema anterior.

### 2.2.1. Principios Físicos De La Medición De Nivel De Líquidos

Dos principios complementarios sustentan la medición de nivel. El primero es la presión hidrostática: la presión ejercida por una columna de líquido en reposo depende de la densidad del fluido, de la aceleración de la gravedad y de la altura de la columna, y es independiente de la forma del recipiente (Cengel y Cimbala, 2006; Tippens, 2009):

p = p0 + ρg h | (19)

donde:

p0 : presión sobre la superficie libre, atmosférica en un depósito abierto (Pa)

h : altura de la columna de líquido sobre el punto de medición (m)

En un depósito de doce centímetros de altura de agua, la presión manométrica en el fondo alcanza apenas 1,18 kPa, es decir, algo más de un uno por ciento de la presión atmosférica. Ese orden de magnitud explica por qué un transductor de presión aplicado a un depósito pequeño exige alta resolución y una cadena de acondicionamiento cuidadosa.

El segundo principio es el de Arquímedes: un cuerpo sumergido experimenta un empuje vertical igual al peso del fluido desplazado (Tippens, 2009):

FE = ρfluido g Vdesplazado | (20)

La condición de equilibrio de un flotador impone que el empuje iguale al peso propio, lo que determina la fracción sumergida:

ρflotador Vtotal = ρfluido Vsumergido ⟹ Vsumergido / Vtotal = ρflotador / ρfluido | (21)

De la ecuación (21) se sigue una consecuencia de diseño: un flotador cuya densidad sea la mitad de la del agua flotará con la mitad de su volumen sumergido y acompañará la superficie con un desfase constante, lo que hace previsible la posición angular a la que cierra el contacto.

Ambos principios transforman una magnitud geométrica —la altura del agua— en una magnitud medible por medios eléctricos o mecánicos. Behera et al. (2023) desarrollaron un sensor hidrostático sumergible que determina la altura de la columna mediante un elemento magnetorresistivo gigante, y Pearce et al. (2024) construyeron un medidor de profundidad basado en sensores de presión diferencial conectados a un microcontrolador. En ambos casos la variable observada no es el nivel sino una magnitud proporcional a él. Del lado de la flotación, Sundararaj et al. (2022) analizaron el comportamiento de un flotador esférico en una válvula de drenaje automática y describieron cómo acompaña el ascenso y descenso del líquido actuando como interruptor mecánico, mientras que Cherif et al. (2025) documentaron un sistema abierto de bajo costo para monitorear el nivel del agua en ambientes acuáticos variables.

En el Smart Plant Bot el depósito es de pequeño volumen y la información requerida no es la altura exacta del agua, sino la existencia o ausencia de reserva suficiente para ejecutar un riego. El principio de flotación resulta por ello más apropiado que la medición de presión: un flotador entrega directamente una condición binaria, sin calibración ni conversión de unidades.

### 2.2.2. Comparación De Tecnologías De Sensado De Nivel

Los sensores de nivel se agrupan según la magnitud física que registran. Los de contacto detectan la posición del líquido mediante un elemento que se desplaza con la superficie; los de presión infieren la altura a partir de la fuerza ejercida sobre el fondo; y los de tiempo de vuelo calculan la distancia hasta la superficie a partir de la propagación de una onda. Cada familia ofrece un compromiso distinto entre exactitud, costo y mantenimiento, de modo que la selección debe responder a las condiciones concretas de la aplicación antes que a la precisión máxima alcanzable. La Tabla 1 resume el principio de funcionamiento, el tipo de salida, la calibración requerida y el costo relativo de cada tecnología.

Tabla 1

Comparación de tecnologías de sensado de nivel aplicables al prototipo

Tecnología | Principio | Salida | Calibración | Costo relativo
Flotador con contacto | Empuje de Arquímedes | Binaria | No requiere | Muy bajo
Presión hidrostática | Columna de líquido | Continua | Requerida | Medio
Ultrasónico | Tiempo de vuelo | Continua | Requerida | Medio
Capacitivo de varilla | Permitividad del medio | Continua | Requerida | Bajo

Nota. Elaboración propia a partir de Behera et al. (2023), Sundararaj et al. (2022), Cherif et al. (2025) y Pearce et al. (2024). El costo relativo se refiere al mercado costarricense en 2026.

Behera et al. (2023) reportaron un sensor sumergible que emplea un elemento magnetorresistivo gigante para registrar la presión hidrostática, y Cherif et al. (2025) implementaron un sistema de monitoreo con transductor ultrasónico y comunicación inalámbrica. Ambas soluciones entregan lectura continua del nivel, pero exigen electrónica de acondicionamiento más elaborada y una calibración inicial que las hace poco convenientes para depósitos pequeños. Pearce et al. (2024) demostraron, en cambio, que un microcontrolador de bajo costo basta para adquirir y registrar las lecturas de un sensor de nivel, lo que confirma la viabilidad de integrar esta medición en arquitecturas abiertas.

El prototipo emplea un sensor de flotador porque la aplicación no exige conocer la altura del agua, sino determinar si el volumen restante permite ejecutar un riego. El dispositivo entrega una señal de dos estados y, al usar una posición mecánica preestablecida como criterio de detección, no requiere la calibración continua propia de los sensores destinados a medir la altura de forma cuantitativa. La contrapartida es que ofrece una única transición y no una medición continua, limitación aceptable dado que la decisión que debe tomar el sistema es igualmente binaria.

### 2.2.3. Lectura Digital Del Sensor Y Acondicionamiento De La Señal

La información que entrega un sensor no llega al microcontrolador en la forma en que este puede procesarla. Entre el elemento sensible y la entrada del controlador debe existir una etapa que adecue la señal: en unos casos amplificándola, en otros convirtiéndola de analógica a digital, y en otros asegurando simplemente que adopte niveles de tensión bien definidos. Esa etapa determina en buena medida la confiabilidad de la lectura, porque una señal débil o inestable produce decisiones erróneas aunque el sensor funcione correctamente.

Los sistemas que miden nivel mediante presión requieren la cadena más extensa. En el sensor de Behera et al. (2023), el elemento magnetorresistivo entrega una variación de resistencia que debe convertirse en tensión proporcional antes de ser digitalizada; Pearce et al. (2024) documentan la interfaz entre un transductor de presión diferencial y un microcontrolador, con la conversión analógica digital y el registro de las lecturas. En ambos casos la magnitud física atraviesa varias transformaciones sucesivas antes de convertirse en un número.

Los sistemas basados en tiempo de vuelo desplazan esa complejidad al interior del propio módulo: el transductor ultrasónico de Cherif et al. (2025) entrega directamente un valor de distancia. Sundararaj et al. (2022), en el extremo opuesto, describen un flotador cuya salida es el cierre o la apertura de un contacto mecánico, señal que ya posee naturaleza binaria y no requiere conversión alguna.

En el Smart Plant Bot conviven ambas situaciones. El sensor capacitivo de humedad entrega una tensión continua que el convertidor traduce a un valor entero, mientras que el flotador entrega un contacto que se interpreta como nivel lógico alto o bajo. Este segundo caso exige una resistencia de polarización conectada a la alimentación, que fije el estado de la entrada mientras el contacto permanece abierto. Sin ella, el terminal quedaría sin referencia definida y el ruido eléctrico del entorno bastaría para que la lectura oscilara entre ambos estados lógicos.

A esa resistencia debe añadirse un tratamiento del rebote del contacto. Todo interruptor mecánico produce, durante algunos milisegundos, una serie de cierres y aperturas sucesivos antes de estabilizarse. La solución adoptada consiste en exigir que la lectura se mantenga estable durante un intervalo mínimo antes de aceptarla como válida, criterio que se implementa por programa y que evita añadir componentes.

### 2.2.4. Lógica De Decisión Combinada Entre Humedad De Suelo Y Nivel De Agua

La decisión de regar no depende de una sola medición, sino de la conjunción de dos condiciones independientes. La primera proviene del sensor capacitivo e indica si el sustrato se encuentra por debajo del umbral de humedad definido. La segunda proviene del flotador e indica si el tanque conserva reserva suficiente. La bomba se activa únicamente cuando ambas se cumplen, lo que corresponde a una operación booleana de conjunción, forma elemental del álgebra de conmutación que gobierna todo circuito lógico (Boylestad y Nashelsky, 2009; Sedra y Smith, 2015):

B = H ∧ N ∧ T , donde H = (θ < θON), N = (nivel suficiente), T = (t − túltimo > tmin) | (22)

Tabla 2

Tabla de verdad de la lógica de habilitación del riego

H (suelo seco) | N (hay agua) | T (tiempo cumplido) | B (bomba) | Condición del sistema
0 | 0 | 0 | 0 | Reposo
1 | 0 | 1 | 0 | Alerta de depósito vacío
0 | 1 | 1 | 0 | Sustrato húmedo, sin acción
1 | 1 | 0 | 0 | Espera entre eventos
1 | 1 | 1 | 1 | Riego habilitado

Nota. Elaboración propia. Se omiten las combinaciones redundantes cuyo resultado coincide con el de una fila ya listada. De las ocho combinaciones posibles de las tres variables, solo una habilita el riego.

El uso de umbrales de humedad como criterio de activación cuenta con respaldo experimental. Campos et al. (2021) verificaron el comportamiento de su plataforma bajo cuatro valores distintos de contenido volumétrico de agua, y Pramanik et al. (2022) obtuvieron resultados equivalentes al vincular las lecturas de humedad con la apertura y el cierre del suministro, según se expuso en el apartado 2.1.4. La incorporación de la condición temporal amplía esa lógica elemental: Bierer (2023) implementó un intervalo mínimo entre eventos y una duración determinada para cada aplicación, criterios que evitan activaciones repetidas antes de que el agua alcance la zona radicular. Jain (2023) integró de forma semejante las lecturas de varios sensores en la decisión de accionamiento, lo que muestra que la automatización admite múltiples entradas sin perder simplicidad.

La condición de nivel cumple una función de protección antes que de medición. Si el flotador indica ausencia de agua, la bomba permanece inhabilitada aunque el sustrato esté seco. Con ello se evita que el motor funcione sin carga y sufra el desgaste asociado a la marcha en vacío, cuyo mecanismo físico se explicó en el apartado 2.1.1. Una bomba que gira sin líquido pierde además la refrigeración que el propio flujo le proporciona, de manera que la salvaguarda es también térmica.

## 2.3. Monitoreo De Variables Ambientales

El monitoreo ambiental es el tercer eje funcional del prototipo y responde al objetivo de identificar las variables más relevantes para estimar el bienestar de la planta. Exige comprender qué magnitudes físicas describen el entorno inmediato del vegetal, mediante qué principios se transforman en señales eléctricas y de qué manera varias lecturas independientes se combinan en una valoración única. Las tres magnitudes seleccionadas —temperatura, humedad relativa e iluminancia— se eligieron porque describen ese entorno inmediato y porque se miden con sensores de bajo costo y lectura directa.

El tema se desarrolla en cuatro subtemas: 2.3.1. Temperatura y humedad relativa del ambiente; 2.3.2. Medición de la iluminancia recibida por la planta; 2.3.3. Física de los semiconductores y sensores digitales; y 2.3.4. Índice simplificado de bienestar vegetal. Los dos primeros describen las magnitudes físicas, el tercero explica cómo se transforman en señales eléctricas y el cuarto las reúne en una valoración única, cerrando así el recorrido iniciado con el riego en el tema 2.1 y continuado con la reserva de agua en el tema 2.2.

### 2.3.1. Temperatura Y Humedad Relativa Del Ambiente

La temperatura expresa la energía cinética media de las moléculas de un cuerpo y se mide con escalas referidas a puntos fijos (Tippens, 2009). La humedad relativa, en cambio, es una razón adimensional entre la presión parcial del vapor de agua presente en el aire y la presión de saturación correspondiente a esa misma temperatura:

HR = (e / es(T)) × 100 % | (23)

donde:

e : presión parcial del vapor de agua (kPa)

es(T) : presión de saturación a la temperatura T (kPa)

La presión de saturación crece de forma exponencial con la temperatura, comportamiento que la ecuación de Magnus-Tetens describe con buena aproximación en el intervalo de interés:

es(T) = 0,6108 · exp[ 17,27 T / (T + 237,3) ] , con T en °C y es en kPa | (24)

De las ecuaciones (23) y (24) se sigue que ambas magnitudes quedan físicamente acopladas: una masa de aire que se enfría sin ganar vapor aumenta su humedad relativa hasta alcanzar el punto de rocío. Ese acoplamiento gobierna el intercambio de agua entre la planta y la atmósfera, y se cuantifica mediante el déficit de presión de vapor:

DPV = es(T) · (1 − HR/100) | (25)

Un cálculo ilustra la magnitud del efecto. A 22 °C con humedad relativa del 70 %, la presión de saturación vale 2,64 kPa y el déficit resulta de 0,79 kPa. Si la temperatura sube a 30 °C manteniendo la misma humedad relativa, la presión de saturación asciende a 4,24 kPa y el déficit se eleva a 1,27 kPa, es decir, un incremento del 61 % en la fuerza que impulsa la pérdida de agua por las hojas. Ese resultado explica por qué la humedad del sustrato cae más rápido en días cálidos aunque la humedad relativa del aire no haya variado, y por qué las dos magnitudes deben leerse juntas y no por separado.

Ikram et al. (2024) señalan que la temperatura y la humedad son los parámetros centrales para caracterizar el microclima vegetal, y que su registro continuo permite identificar condiciones de estrés antes de que se manifiesten visualmente. Qu et al. (2024) desarrollaron sensores flexibles capaces de medir ambas variables sobre la superficie foliar y demostraron que las condiciones inmediatas a la planta llegan a diferir de las del ambiente general, hallazgo que condiciona dónde debe ubicarse el transductor.

Las condiciones favorables para el crecimiento se sitúan en intervalos acotados. Setiawan et al. (2023) establecen un rango conveniente de temperatura entre quince y treinta grados Celsius y una humedad relativa ideal entre sesenta y ochenta por ciento, y advierten que valores inferiores al sesenta por ciento dificultan la fotosíntesis mientras que los superiores al ochenta favorecen procesos de descomposición. Jain (2023) confirma que ambas variables, registradas junto con la humedad del suelo, permiten estimar la necesidad hídrica de la planta.

En el Smart Plant Bot estos intervalos funcionan como referencia de interpretación y no como umbrales de accionamiento. La temperatura y la humedad relativa cumplen función de monitoreo: sus lecturas alimentan el índice ambiental, mientras que la activación de la bomba sigue dependiendo de la humedad del sustrato y de la disponibilidad de agua. Esa separación mantiene simple la lógica de riego y evita que una variación atmosférica transitoria altere el comportamiento del actuador.

### 2.3.2. Medición De La Iluminancia Recibida Por La Planta

La iluminancia mide el flujo luminoso que incide sobre una superficie por unidad de área y se expresa en lux. Es una magnitud fotométrica, esto es, ponderada según la curva de sensibilidad del ojo humano, que asigna mayor peso a las longitudes de onda cercanas al verde (Tippens, 2009). Para una fuente puntual, su valor obedece a la ley del inverso del cuadrado combinada con la ley del coseno de Lambert:

E = (I / r²) · cos θ | (26)

donde:

E : iluminancia sobre la superficie (lx)

I : intensidad luminosa de la fuente (cd)

r : distancia entre la fuente y la superficie (m)

θ : ángulo entre la normal a la superficie y la dirección de incidencia

La consecuencia práctica de la ecuación (26) es severa. Duplicar la distancia de la planta a la ventana reduce la iluminancia a la cuarta parte, y una inclinación de 60° respecto de la normal la reduce a la mitad. Un desplazamiento de treinta centímetros sobre un alféizar cambia la lectura de forma más apreciable que la nubosidad de la jornada, razón por la cual el sensor debe permanecer en una posición fija y representativa, con la orientación y la distancia a la ventana documentadas para que las mediciones resulten reproducibles entre pruebas. Ikram et al. (2024) subrayan precisamente que el desempeño declarado por el fabricante de un sensor debe verificarse en las condiciones reales de instalación, y Qu et al. (2024) mostraron que el microclima inmediato a la hoja difiere del ambiente general.

La ponderación fotométrica introduce una distinción que conviene mantener explícita. La fotosíntesis no responde a la sensibilidad visual humana, sino a la cantidad de fotones disponibles en el intervalo de radiación fotosintéticamente activa, entre 400 y 700 nanómetros, magnitud que se expresa en micromoles por metro cuadrado y por segundo. La conversión entre ambas depende de la distribución espectral de la fuente:

PPFD ≈ E / kλ , con kλ ≈ 54 para luz solar y kλ ≈ 75 para lámparas fluorescentes blancas | (27)

El factor kλ no es universal: dos fuentes que producen la misma iluminancia aportan cantidades muy distintas de radiación aprovechable. La integral diaria de luz acumula el aporte a lo largo de la jornada y constituye el indicador que la literatura agronómica emplea con preferencia:

DLI = ∫ PPFD dt ≈ PPFDmedia × tfotoperíodo × 3600 / 10⁶ [mol·m⁻²·d⁻¹] | (28)

Jin et al. (2023) evaluaron distintos niveles de densidad de flujo fotónico sobre cultivos de lechuga y observaron diferencias significativas en la acumulación de biomasa, lo que confirma que la cantidad de luz condiciona el crecimiento. Sugano et al. (2024) estudiaron plantas ornamentales de interior bajo distintos niveles de iluminación en cámaras que simulaban ambientes de trabajo, y comprobaron que tanto la cantidad como la duración de la exposición modifican de manera apreciable el desarrollo vegetal. Setiawan et al. (2023), por su parte, emplearon un sensor de luz para activar iluminación complementaria cuando la lectura descendía por debajo de un umbral.

En el prototipo la iluminancia se registra en lux y se emplea como referencia orientativa de la disponibilidad de luz, sin pretender describir la radiación útil para la fotosíntesis. Las lecturas permiten comparar situaciones bajo una misma fuente, pero no equipararlas entre fuentes de espectro diferente, limitación que debe declararse de forma explícita en la interpretación de los resultados.

### 2.3.3. Física De Los Semiconductores Y Sensores Digitales

Todos los transductores del prototipo, y también el diodo de protección y el transistor de la etapa de potencia, se apoyan en el comportamiento de la unión PN. Un cristal semiconductor dopado con impurezas donadoras cede electrones libres y produce material de tipo N; dopado con impurezas aceptoras genera vacantes y produce material de tipo P. Al unir ambas regiones, la difusión de portadores establece una zona de agotamiento poblada por iones fijos y un campo eléctrico interno que se opone a la difusión ulterior (Boylestad y Nashelsky, 2009; Tippens, 2009).

La relación entre la corriente y la tensión aplicada a esa unión responde al modelo exponencial de Shockley, cuya deducción a partir de las estadísticas de portadores desarrollan Sedra y Smith (2015):

I = IS [ exp(V / n VT) − 1 ] , con VT = kT / q | (29)

donde:

IS : corriente inversa de saturación (A)

n : factor de idealidad, entre 1 y 2 según el dispositivo

VT : tensión térmica, ≈ 25,9 mV a 300 K

k : constante de Boltzmann, 1,381 × 10⁻²³ J/K

q : carga elemental, 1,602 × 10⁻¹⁹ C

La dependencia de VT con la temperatura absoluta es precisamente lo que hace posible el sensado térmico de estado sólido: la tensión de unión de un diodo o de un transistor varía de forma previsible con la temperatura, a razón de unos −2 mV/K a corriente constante, lo que permite deducirla a partir de una medición eléctrica. Los sensores digitales aprovechan ese comportamiento calibrando la respuesta durante la fabricación, de modo que el dispositivo entrega directamente un valor de temperatura.

Los sensores de luz se apoyan en el efecto fotoeléctrico interno. Los fotones cuya energía supera el ancho de banda prohibida del material liberan pares electrón-hueco, y el campo de la zona de agotamiento los separa y genera una corriente proporcional a la irradiancia recibida:

Iph = q ηc Φ Aefectiva , con la condición hν ≥ Eg | (30)

donde:

ηc : eficiencia cuántica del detector

Φ : densidad de flujo de fotones incidentes (fotones·m⁻²·s⁻¹)

Eg : energía del ancho de banda prohibida del semiconductor (eV)

La misma física explica el comportamiento del diodo de protección de la etapa de potencia. En polarización directa la caída de tensión se estabiliza alrededor de 0,7 V para uniones de silicio, valor que acota la sobretensión que el transistor debe soportar durante la apertura, según se desarrolla en el apartado 2.4.2.

Sobre esa base física se construyen los sensores digitales. Un sensor digital incorpora en su propio encapsulado el elemento sensible, la etapa de acondicionamiento y el convertidor, de modo que entrega al microcontrolador un valor ya cuantificado a través de un protocolo de comunicación. Esa arquitectura contrasta con la de un sensor analógico, cuya salida debe recorrer una cadena externa de acondicionamiento. La diferencia se traduce en menor sensibilidad al ruido, porque la información viaja codificada en niveles lógicos y no en amplitudes de tensión, ventaja que se aprecia sobre todo cuando el cableado es largo.

Bierer (2023) empleó sensores digitales de temperatura conectados mediante un protocolo de un solo hilo, en el que una única línea de datos atiende hasta dieciséis dispositivos identificados por dirección. Setiawan et al. (2023) integraron en una misma placa un sensor combinado de temperatura y humedad junto con un elemento fotosensible, y demostraron que ambas magnitudes se adquieren de forma simultánea. Ikram et al. (2024) advierten, no obstante, que el desempeño declarado por el fabricante debe verificarse en las condiciones reales de uso.

Tabla 3

Transductores ambientales seleccionados y sus características declaradas

Sensor | Magnitud | Intervalo | Exactitud declarada | Interfaz
DHT22 | Temperatura | −40 a 80 °C | ± 0,5 °C | Un hilo
DHT22 | Humedad relativa | 0 a 100 % | ± 2 a 5 % | Un hilo
BH1750 | Iluminancia | 1 a 65 535 lx | ± 20 % | I²C (0x23)
Capacitivo v1.2 | Humedad de suelo | Salida 0 a 3,0 V | Requiere calibración | Analógica
Flotador | Nivel de tanque | Binaria | Posición mecánica | Digital

Nota. Valores tomados de las hojas de datos de los fabricantes. La exactitud del sensor capacitivo no se declara porque su salida depende del sustrato y exige la calibración descrita en el apartado 2.1.2.

El bus de dos hilos empleado por el BH1750 permite incorporar dispositivos adicionales sin ocupar terminales del microcontrolador, ya que cada uno se distingue por una dirección propia. Ambos transductores entregan lecturas ya convertidas, lo que simplifica la programación y permite evaluar cada sensor de forma independiente durante las pruebas. Esa modularidad tiene valor en un prototipo educativo, donde la posibilidad de aislar fallas importa tanto como la exactitud de la medición.

### 2.3.4. Índice Simplificado De Bienestar Vegetal

Un índice compuesto reúne varias magnitudes de naturaleza distinta en un único valor interpretable. Su construcción exige dos operaciones previas: normalizar cada variable, es decir, llevarla a una escala común que elimine sus unidades originales, y ponderarla según la importancia atribuida a cada factor. Sin ellas no sería posible combinar grados Celsius, porcentajes de humedad y lux, magnitudes que carecen de denominador común.

La normalización más sencilla asigna un valor discreto según la variable caiga o no dentro de un intervalo aceptable:

si = 1 si xi,min ≤ xi ≤ xi,max ; si = 0 en caso contrario | (31)

El índice resulta entonces de la suma ponderada de los indicadores parciales:

IBV = Σ wi si , con Σ wi = 1 y 0 ≤ IBV ≤ 1 | (32)

El resultado se traduce a tres categorías interpretables: condición favorable para IBV ≥ 0,75, condición aceptable entre 0,40 y 0,75, y condición desfavorable por debajo de 0,40. Los pesos wi y los intervalos [xi,min, xi,max] deben fijarse antes de las pruebas y quedar documentados, porque su elección determina por completo el resultado y varía según la especie considerada.

Tabla 4

Intervalos de referencia e indicadores parciales del índice de bienestar vegetal

Variable | Intervalo de referencia | Peso wi | Fuente del intervalo | Función
Humedad de suelo | 40 a 70 % VWC | 0,40 | Campos et al. (2021) | Control y monitoreo
Temperatura | 15 a 30 °C | 0,25 | Setiawan et al. (2023) | Solo monitoreo
Humedad relativa | 60 a 80 % | 0,20 | Setiawan et al. (2023) | Solo monitoreo
Iluminancia | 1000 a 10 000 lx | 0,15 | Sugano et al. (2024) | Solo monitoreo

Nota. Los pesos constituyen una propuesta de diseño del proyecto y no derivan de un estudio agronómico. Se asignó el mayor peso a la humedad de suelo por ser la única variable sobre la que el sistema actúa. Los intervalos corresponden a plantas ornamentales de interior de requerimientos medios y deben ajustarse a la especie empleada.

La pertinencia de considerar las variables de manera conjunta se apoya en evidencia experimental. Sugano et al. (2024) mantuvieron controladas la temperatura y la humedad relativa mientras variaban la iluminación, y observaron que la respuesta de las plantas ornamentales dependía de la combinación de condiciones y no de un factor aislado. Qu et al. (2024) sostienen de forma semejante que el estado del microclima vegetal solo se caracteriza adecuadamente mediante el registro simultáneo de varias magnitudes.

Conviene declarar la limitación de manera explícita. Existen indicadores consolidados para valorar el estado de la vegetación, generalmente basados en la respuesta espectral de las hojas, pero Ikram et al. (2024) señalan que su aplicación exige sensores ópticos especializados o información espectral que excede las posibilidades de una plataforma de bajo costo. El índice propuesto aquí no pretende equipararse a esos métodos ni sustituirlos: ofrece una lectura resumida de las condiciones medidas y no un diagnóstico fisiológico. Documentar los pesos y los intervalos permite además que otra persona reproduzca la valoración y verifique su coherencia con las lecturas registradas.

## 2.4. Modelado Del Comportamiento Dinámico Mediante Ecuaciones Diferenciales

Los subsistemas descritos hasta aquí se han caracterizado en régimen permanente, descripción insuficiente para explicar lo que ocurre durante las transiciones. Este tema introduce el aparato matemático que permite describirlas, lo aplica al transitorio que se produce al desconectar la carga inductiva y cierra con el modelo de la pérdida de agua del sustrato entre dos eventos de riego. Los tres procesos comparten estructura matemática, de modo que el análisis de cualquiera de ellos resulta transferible a los restantes.

El tema se desarrolla en cuatro subtemas: 2.4.1. Ecuaciones diferenciales de primer orden y constante de tiempo; 2.4.2. Transitorio de desconexión de la carga inductiva; 2.4.3. Modelo de pérdida de humedad del sustrato entre eventos de riego; y 2.4.4. Aplicación de los modelos al dimensionamiento del prototipo. El primero aporta la herramienta matemática, los dos siguientes la aplican a fenómenos de naturaleza muy distinta y el cuarto traduce ambos resultados en decisiones de diseño, que es lo que este tema añade a los tres anteriores.

### 2.4.1. Ecuaciones Diferenciales De Primer Orden Y Constante De Tiempo

Una ecuación diferencial ordinaria relaciona una función desconocida con sus derivadas respecto de una única variable independiente, que en los sistemas considerados es el tiempo. El orden queda determinado por la derivada de mayor grado, de manera que las de primer orden contienen únicamente la primera derivada (Zill, 2018). Esa categoría describe la mayoría de los procesos de acumulación y disipación presentes en el prototipo.

La forma lineal homogénea de coeficientes constantes es el caso de mayor interés para el análisis de transitorios:

dy/dt + (1/τ) y = 0 , con condición inicial y(0) = y0 | (33)

Su solución es una exponencial decreciente:

y(t) = y0 exp(−t / τ) | (34)

La constante τ recibe el nombre de constante de tiempo y posee un significado físico inmediato: es el intervalo transcurrido hasta que la variable alcanza el 36,8 % de su valor inicial. Se admite por convención que el transitorio se ha extinguido tras cinco constantes de tiempo, momento en que la desviación respecto del valor final es inferior al uno por ciento, criterio de uso corriente tanto en el análisis de circuitos (Boylestad y Nashelsky, 2009; Sedra y Smith, 2015) como en el de procesos térmicos e hidráulicos (Cengel y Cimbala, 2006).

La incorporación de un término independiente convierte la ecuación en no homogénea y describe la situación en que el sistema está sometido a una excitación externa constante:

y(t) = y∞ + (y0 − y∞) exp(−t / τ) | (35)

La solución se compone de dos sumandos: la respuesta natural, que decae con la constante de tiempo del sistema, y la respuesta forzada, que determina el valor de régimen permanente. Esa descomposición separa con claridad lo que el sistema aporta por sí mismo de lo que le impone la excitación. Para coeficientes variables —situación que se presenta cuando algún parámetro depende del tiempo— el método del factor integrante proporciona un procedimiento sistemático de resolución. En el prototipo los parámetros se consideran constantes durante cada intervalo de análisis, de modo que ese método resulta prescindible, aunque su conocimiento permite abordar los casos en que la temperatura modifica de forma apreciable los valores de los componentes.

### 2.4.2. Transitorio De Desconexión De La Carga Inductiva

El comportamiento de un devanado recorrido por corriente queda descrito por la ley constitutiva del elemento inductivo (Boylestad y Nashelsky, 2009; Tippens, 2009):

vL = L di/dt | (36)

De la ecuación (36) se sigue que la corriente no admite variaciones instantáneas, porque ello exigiría una tensión de magnitud infinita. Esa imposibilidad explica el fenómeno que motiva la presencia del diodo de protección. Al establecer el equilibrio de tensiones en la malla formada por el devanado y su resistencia asociada tras la apertura del conmutador, se obtiene:

L di/dt + Rtotal i = 0 ⟹ i(t) = I0 exp(−t Rtotal / L) , τ = L / Rtotal | (37)

El valor de Rtotal determina por completo la duración del transitorio y, con ella, la magnitud de la sobretensión desarrollada en el instante de apertura. Sin camino de circulación, la resistencia del circuito se aproxima a la que presenta el transistor abierto, del orden de megaohmios, de modo que la constante de tiempo tiende a cero y la tensión inducida alcanza magnitudes capaces de destruir el dispositivo.

El diodo en antiparalelo modifica ese escenario de raíz: ofrece un camino cuya resistencia equivale a la del propio devanado más la reducida caída directa del componente (Sedra y Smith, 2015). Bierer (2023) resuelve esta protección con un diodo 1N4007 dispuesto sobre la carga, y la solución de la ecuación diferencial resultante sigue el procedimiento estándar para ecuaciones lineales homogéneas (Zill, 2018). La tensión soportada por el transistor queda entonces acotada a:

VDS,máx ≈ Valim + VF ≈ 12 V + 0,7 V = 12,7 V | (38)

La constante de tiempo resultante alarga la extinción de la corriente, circunstancia admisible en una aplicación cuya frecuencia de conmutación es baja. La energía que el diodo debe disipar coincide con la almacenada en el campo magnético en el instante previo a la apertura:

WL = ½ L I0² | (39)

Ese valor permite verificar que el diodo seleccionado admita el pico de corriente y la energía correspondiente sin superar su temperatura máxima de unión, mediante la relación térmica ya presentada en la ecuación (17). El modelo diferencial convierte así una recomendación de diseño de carácter empírico —«poner siempre un diodo»— en un criterio cuantitativo verificable, que es precisamente el propósito formativo del proyecto.

### 2.4.3. Modelo De Pérdida De Humedad Del Sustrato Entre Eventos De Riego

La evolución del contenido de agua de un sustrato entre dos riegos consecutivos admite una descripción mediante balance de masa: la variación temporal del volumen almacenado equivale a la diferencia entre aportes y pérdidas. En ausencia de riego el término de aporte se anula, de modo que la variación queda gobernada por la evaporación desde la superficie y por la transpiración del vegetal (Ikram et al., 2024; Qu et al., 2024):

d θ/dt = R(t) − ET(t) , y en ausencia de riego d θ/dt = − ET(t) | (40)

La hipótesis más simple supone que la velocidad de pérdida es proporcional al agua disponible en cada instante, supuesto que conduce a la ecuación homogénea de primer orden ya resuelta en el apartado 2.4.1 (Zill, 2018). Campos et al. (2021) trabajaron con contenidos volumétricos de agua dentro de intervalos acotados, condición bajo la cual esa aproximación lineal resulta razonable:

θ(t) = θ0 exp(−t / τs) , con τs dependiente del sustrato y del DPV | (41)

Invertir la ecuación (41) proporciona el intervalo previsto entre eventos de riego, magnitud de interés directo para el diseño del depósito:

triego = τs · ln(θ0 / θON) | (42)

Con una constante de tiempo del sustrato de 120 horas, un contenido inicial del 70 % y un umbral de activación del 40 %, la ecuación (42) predice un intervalo cercano a 67 horas entre riegos. Ese resultado es el que permite dimensionar el tanque en el apartado 2.6.2. Conviene subrayar, sin embargo, que τs no es una constante del sistema sino una función del déficit de presión de vapor definido en la ecuación (25): períodos cálidos y secos la reducen de forma apreciable y acortan el intervalo real. El modelo entrega por tanto una estimación de orden de magnitud, útil para el diseño y no para la operación, que sigue gobernada por la medición directa del sensor.

### 2.4.4. Aplicación De Los Modelos Al Dimensionamiento Del Prototipo

Los dos modelos anteriores no se plantean como ejercicio formal: cada uno produce una cifra que condiciona una decisión constructiva concreta. El transitorio de la ecuación (37) determina la tensión máxima que soporta el transistor y, con ella, el margen de seguridad exigible al componente; la energía almacenada de la ecuación (39) fija la corriente de pico que el diodo debe admitir. Ambos resultados alimentan la verificación térmica de la ecuación (17), de modo que la selección de la etapa de potencia deja de apoyarse en una regla práctica y pasa a sustentarse en un cálculo.

El modelo hídrico opera en la dirección contraria: parte de una constante de tiempo estimada y entrega el intervalo previsto entre riegos, magnitud de la que dependen tanto el volumen del depósito como la autonomía del sistema. Su valor no es un dato de operación sino un criterio de dimensionamiento, según se desarrolla en el apartado 2.6.2. Conviene subrayar que ambos modelos comparten la misma estructura matemática pese a describir fenómenos sin relación aparente, hecho que ilustra el poder descriptivo de las ecuaciones diferenciales de primer orden (Zill, 2018).

La validez de ambas descripciones tiene límites que conviene declarar. El modelo del transitorio inductivo supone inductancia constante y desprecia el efecto de las capacidades parásitas del devanado, hipótesis razonable a la baja frecuencia de conmutación del prototipo pero no en régimen modulado (Boylestad y Nashelsky, 2009; Sedra y Smith, 2015). El modelo hídrico supone una velocidad de pérdida proporcional al agua disponible, cuando la evidencia experimental muestra que depende además del déficit de presión de vapor (Ikram et al., 2024; Qu et al., 2024), por lo que ambos deben entenderse como aproximaciones de primer orden y no como descripciones exactas.

Establecidas las herramientas de modelado dinámico, corresponde examinar los circuitos que entregan al microcontrolador una señal fiel de cada magnitud medida, contenido que aborda el tema siguiente.

## 2.5. Acondicionamiento Analógico De Las Señales De Los Sensores

Entre el elemento sensible y la entrada del microcontrolador media siempre una cadena de circuitos cuya función no es amplificar ni decidir, sino entregar al convertidor una señal cuyo valor represente fielmente la magnitud física. Este tema recorre esa cadena en el orden en que la señal la atraviesa: la conversión resistencia-tensión mediante divisor, el filtrado del ruido, la adaptación de impedancias, la comparación con histéresis, la fuente que alimenta todo el conjunto y, por último, la cuantificación en el convertidor.

El tema se desarrolla en cuatro subtemas: 2.5.1. Divisor de tensión y punto de máxima sensibilidad; 2.5.2. Filtrado pasa bajas y adaptación de impedancia; 2.5.3. Comparación con histéresis mediante realimentación positiva; y 2.5.4. Alimentación y conversión analógica digital. Los tres primeros recorren la cadena de la señal en el orden en que esta la atraviesa, y el cuarto reúne las dos condiciones que la hacen posible: una alimentación estable y una cuantificación de resolución suficiente.

### 2.5.1. Divisor De Tensión Y Punto De Máxima Sensibilidad

El microcontrolador no admite la lectura directa de una resistencia, de modo que todo elemento resistivo variable debe integrarse en un divisor que traduzca la variación resistiva en variación de tensión (Boylestad y Nashelsky, 2009). Es el caso de la fotorresistencia empleada en la simulación como sustituto del sensor de iluminancia:

Vout = Vcc · Rfija / (RLDR + Rfija) | (43)

La elección del valor de Rfija determina el intervalo en el que el divisor presenta su mayor sensibilidad. Derivando la ecuación (43) respecto de la resistencia variable se obtiene:

dVout / dRLDR = − Vcc Rfija / (RLDR + Rfija)² | (44)

El módulo de la ecuación (44) alcanza su máximo cuando RLDR = Rfija, resultado que fija el criterio de diseño: la resistencia fija debe igualar la resistencia del elemento sensible en el punto medio del intervalo de operación previsto. El valor de diez kiloohmios adoptado en el circuito sitúa el punto de mayor pendiente dentro del intervalo de iluminación de interior, que es el ámbito de trabajo del prototipo. Setiawan et al. (2023) resolvieron la lectura de intensidad lumínica con un elemento fotosensible dispuesto en la misma configuración, y Sedra y Smith (2015) desarrollan el análisis general de esta red resistiva junto con sus limitaciones de linealidad. La contrapartida es que la respuesta se comprime en los extremos de la escala, donde la sensibilidad cae de forma cuadrática.

Conviene advertir que la lectura obtenida del convertidor es un número entero proporcional a la tensión y no una medida de iluminancia en unidades fotométricas. El programa opera por tanto sobre comparaciones relativas entre lecturas y no sobre magnitudes absolutas, criterio coherente con la función que el subsistema desempeña dentro de la simulación. En el prototipo físico, el BH1750 entrega directamente el valor en lux y esta etapa no resulta necesaria.

### 2.5.2. Filtrado Pasa Bajas Y Adaptación De Impedancia

Toda señal analógica que recorre un cableado captura ruido del entorno, procedente de la conmutación de la etapa de potencia, de la red eléctrica y del acoplamiento electromagnético entre conductores próximos. Un filtro pasa bajas de primer orden, formado por una resistencia y un condensador, atenúa las componentes de frecuencia superior a un valor definido (Boylestad y Nashelsky, 2009; Sedra y Smith, 2015):

H(f) = 1 / √(1 + (f / fc)²) , con fc = 1 / (2π R C) | (45)

La elección de la frecuencia de corte establece un compromiso explícito entre inmunidad al ruido y velocidad de respuesta. Como la iluminación y la humedad del sustrato evolucionan en escalas de minutos, resulta admisible una frecuencia de corte muy reducida que atenúe con severidad cualquier componente rápida. Con R = 10 kΩ y C = 100 nF se obtiene fc ≈ 159 Hz, valor que ya rechaza el rizado de 120 Hz procedente de la fuente sin degradar la respuesta a las variaciones de interés.

La resistencia del filtro, sin embargo, se suma a la impedancia que presenta la fuente de señal, lo que introduce un efecto secundario sobre el proceso de conversión. Un valor excesivo impide que el condensador interno de muestreo del convertidor alcance su valor final dentro del intervalo de adquisición, y origina un error sistemático. Los fabricantes de microcontroladores recomiendan por ello una impedancia de fuente inferior a diez kiloohmios, criterio que conduce a preferir resistencia baja acompañada de capacitancia elevada.

El filtro resuelve el ruido, pero no el efecto de carga. Conectar un divisor de resistencia elevada a una carga de impedancia comparable altera de forma apreciable la tensión que el divisor entrega. La carga se sitúa en paralelo con la rama inferior y reduce su resistencia equivalente:

Vout = Vcc · (R2 ∥ RL) / [R1 + (R2 ∥ RL)] , con R2 ∥ RL = R2RL / (R2 + RL) | (46)

La desviación no es constante, sino dependiente del punto de operación, lo que impide corregirla mediante un simple factor. El amplificador operacional configurado como seguidor de tensión resuelve la dificultad conectando su salida directamente a la entrada inversora, disposición que establece ganancia unitaria. La entrada no inversora presenta impedancia muy elevada y no extrae corriente apreciable del divisor, mientras que la salida posee impedancia reducida capaz de gobernar la etapa siguiente. El dispositivo desacopla ambos circuitos sin alterar el valor de la tensión.

El fundamento de ese comportamiento reside en las dos aproximaciones que gobiernan el análisis del operacional realimentado negativamente: la ausencia de corriente por sus entradas y la igualdad de potencial entre ambas (Sedra y Smith, 2015). La necesidad de esta etapa se aprecia con claridad en los sistemas de medición de nivel por presión, donde el elemento sensible entrega variaciones de resistencia de amplitud reducida que deben amplificarse antes de digitalizarse (Behera et al., 2023; Pearce et al., 2024). Ambas se sostienen mientras la ganancia en lazo abierto sea muy elevada y el dispositivo opere dentro de su región lineal. La selección del componente concreto exige atender a parámetros que esas idealizaciones ignoran, entre ellos la tensión de desviación entre entradas, la corriente de polarización y el intervalo de tensiones que la salida alcanza efectivamente. Un dispositivo cuya salida no llegue a los extremos de la alimentación introduce una zona muerta en los límites de la escala y reduce el intervalo útil de medición.

En el circuito del prototipo la resistencia del divisor y la impedancia de entrada del convertidor difieren en varios órdenes de magnitud, condición que hace prescindible esta etapa en la configuración actual. Su incorporación resultaría necesaria si el valor de la resistencia fija se elevara para desplazar el intervalo de sensibilidad, o si la señal debiera distribuirse simultáneamente a varias etapas. El seguidor de tensión no amplifica: aísla. La distinción conviene subrayarla porque resulta contraintuitiva y porque su utilidad se manifiesta precisamente donde la señal debe conservarse sin alteración pese a que la etapa siguiente demande corriente.

### 2.5.3. Comparación Con Histéresis Mediante Realimentación Positiva

La conversión de una señal continua en una decisión binaria vincula la etapa de medición con la de accionamiento, y admite tanto una implementación analógica como una resolución por programa. El comparador simple establece la decisión contrastando la señal con una tensión de referencia y saturando su salida en uno de los dos extremos según el signo de la diferencia (Boylestad y Nashelsky, 2009).

Esa implementación elemental falla cuando la señal evoluciona con lentitud y está acompañada de ruido, situación que corresponde exactamente a la del prototipo. En las proximidades del umbral, el ruido superpuesto produce cruces repetidos de la referencia y la salida conmuta muchas veces en un intervalo breve, comportamiento inadmisible cuando gobierna un actuador mecánico. La solución consiste en añadir una realimentación positiva mediante una resistencia conectada entre la salida y la entrada no inversora, disposición conocida como disparador de Schmitt, que establece dos umbrales distintos según el estado de la salida (Sedra y Smith, 2015). Bierer (2023) resuelve el mismo problema por programa mediante un intervalo mínimo entre eventos, y Campos et al. (2021) mediante la comparación contra umbrales fijos previamente calibrados:

VTH+ = Vref + (R1 / R2)(Vsat+ − Vref) ; VTH− = Vref + (R1 / R2)(Vsat− − Vref) | (47)

ΔVH = VTH+ − VTH− = (R1 / R2)(Vsat+ − Vsat−) | (48)

Una vez producida la conmutación, la propia salida desplaza el umbral en el sentido que dificulta el retorno al estado anterior. La señal debe apartarse de manera apreciable del punto de conmutación para que el sistema regrese a su condición previa, comportamiento que confiere inmunidad frente a perturbaciones de amplitud inferior a la anchura de histéresis.

El prototipo implementa esta misma lógica por programa y no mediante componentes discretos, decisión que responde a criterios de costo, de espacio y de flexibilidad de ajuste. La implementación numérica permite modificar la anchura de histéresis sin alterar el circuito y admite el registro simultáneo del valor de la señal, algo imposible cuando la decisión se resuelve enteramente en el dominio analógico. Comprender el disparador de Schmitt sigue siendo necesario, porque los parámetros que se ajustan por programa en la ecuación (18) tienen significado idéntico al de sus equivalentes analógicos de las ecuaciones (47) y (48).

### 2.5.4. Alimentación Y Conversión Analógica Digital

El prototipo se alimenta de la red eléctrica, de modo que la señal debe rectificarse, filtrarse y regularse antes de llegar a los circuitos. En una rectificación de onda completa, una entrada de 60 Hz genera una señal pulsante cuya frecuencia de rizado es el doble de la de entrada:

frizado = 2 fred = 120 Hz | (49)

Por superposición, esa señal se describe como una componente continua acompañada de componentes armónicas. El condensador de filtro almacena energía durante los máximos y la entrega cuando la tensión disminuye, lo que atenúa las variaciones. La amplitud del rizado resultante se aproxima mediante:

ΔVrizado ≈ Icarga / (frizado C) | (50)

Con una corriente de carga de 500 mA y un condensador de 1000 μF, la ecuación (50) predice un rizado cercano a 4,2 V, valor que confirma la necesidad de una etapa reguladora posterior. Liu et al. (2023) y Li et al. (2025) analizan ese rizado en convertidores monofásicos y proponen estrategias de desacoplo de potencia para reducirlo, mientras que Zhao et al. (2025) y Zhang et al. (2026) estudian el filtrado específico a 120 Hz mediante estructuras de almacenamiento de energía. Para el prototipo, la solución adoptada es una fuente conmutada comercial de doce voltios seguida de un regulador que entrega los cinco voltios de la lógica.

Conviene señalar una discrepancia entre el análisis teórico y el modelo simulado. En el esquema de Proteus, las fuentes V1 y V2 se representan como generadores de tensión continua ideales, de modo que la simulación no reproduce el rizado descrito por las ecuaciones (49) y (50). El análisis anterior corresponde por tanto a la etapa de alimentación prevista para el montaje físico, y su verificación queda pendiente para esa fase.

Resuelta la alimentación, resta el último eslabón de la cadena. El microcontrolador solo opera con valores discretos, de modo que su convertidor de aproximaciones sucesivas asigna a cada tensión de entrada un número entero dentro de un intervalo definido por el número de bits:

N = redondeo[ (Vin / Vref) · (2^n − 1) ] | (51)

La resolución, entendida como el escalón de tensión que corresponde a un incremento unitario del código, resulta de:

ΔV = Vref / 2^n = 5,00 V / 1024 = 4,88 mV | (52)

El error de cuantificación queda acotado a la mitad de ese escalón, es decir, ± 2,44 mV para el convertidor de diez bits del Arduino Uno. Trasladado al sensor capacitivo de humedad, cuya salida recorre aproximadamente 1,4 V entre el estado seco y el saturado, esa resolución equivale a unas 287 cuentas para todo el intervalo útil, o cerca de un 0,35 % del contenido volumétrico por cuenta. Ese valor es holgadamente suficiente frente a la incertidumbre del propio sensor, lo que confirma que la limitación de la medición reside en el transductor y en su calibración, no en la conversión.

El promediado de varias muestras consecutivas atenúa además el ruido introducido por el propio convertidor y por la longitud del cableado, a costa de reducir la frecuencia efectiva de muestreo. Como las magnitudes de interés evolucionan en escalas de minutos, esa reducción no supone inconveniente alguno.

## 2.6. Diseño Mecánico De La Estructura

La estructura no es un envase que aloja componentes: define la geometría del volumen de sustrato, fija la altura que la bomba debe vencer, determina la posición relativa de los sensores y condiciona la reproducibilidad de las mediciones. Este tema desarrolla la geometría de la carcasa, el dimensionamiento del depósito a partir del modelo hídrico del apartado 2.4.3 y los criterios de material y manufactura.

El tema se desarrolla en cuatro subtemas: 2.6.1. Geometría de la carcasa hexagonal; 2.6.2. Dimensionamiento del depósito y balance hídrico; 2.6.3. Materiales, esfuerzos y manufactura; y 2.6.4. Integración de los sensores en la estructura. Los tres primeros definen la forma, el volumen y el material del conjunto, y el cuarto establece las condiciones geométricas sin las cuales las mediciones descritas en los temas 2.1 a 2.3 no resultarían reproducibles entre ensayos.

### 2.6.1. Geometría De La Carcasa Hexagonal

La carcasa se diseñó como un prisma hexagonal regular, elección que responde a tres criterios. El hexágono ofrece una relación área-perímetro superior a la de un prisma cuadrado para el mismo volumen, lo que reduce la superficie de sustrato expuesta a la evaporación. Sus paredes planas facilitan el montaje de los sensores sin requerir superficies curvas. Y permite disponer las cavidades internas para la bomba, el tubo de riego y los soportes sin comprometer el volumen útil de sustrato. Esa reducción de la superficie expuesta importa porque la evaporación desde el sustrato depende directamente del área libre y del déficit de presión de vapor del aire circundante (Ikram et al., 2024; Qu et al., 2024), y porque en cultivos de traspatio la uniformidad de la humedad condiciona el desarrollo vegetal (Jiménez, 2025). El área de la base responde a:

Ahex = (3√3 / 2) a² ≈ 2,598 a² | (53)

donde:

a : longitud del lado del hexágono (m)

El volumen del prisma resulta del producto del área por la altura útil:

V = Ahex · hútil | (54)

Con un lado de 70 mm y una altura útil de sustrato de 100 mm, las ecuaciones (53) y (54) entregan un área de base de 127,3 cm² y un volumen de sustrato próximo a 1,27 litros, dimensión adecuada para una planta ornamental de interior de porte medio. La superficie expuesta a evaporación coincide con el área de base, dato que alimenta el modelo de pérdida de humedad. La geometría fija además la altura de la columna de sustrato y, con ella, la distribución de presión sobre las paredes descrita por la hidrostática (Cengel y Cimbala, 2006) y la carga que la base debe soportar sin flexión apreciable (Hibbeler, 2011).

### 2.6.2. Dimensionamiento Del Depósito Y Balance Hídrico

El volumen del tanque debe garantizar un número razonable de eventos de riego antes de exigir recarga. El volumen entregado por evento se obtiene del caudal efectivo de la bomba y del tiempo de accionamiento, según se estableció en la ecuación (1) a partir de la conservación de la masa (Cengel y Cimbala, 2006). Bierer (2023) parametriza precisamente esa duración como una constante configurable del sistema:

Vevento = Qefectivo · tbomba | (55)

El número de eventos que el depósito sostiene resulta entonces de:

neventos = Vtanque / Vevento ; tautonomía = neventos · triego | (56)

Combinando las ecuaciones (42), (55) y (56) se obtiene el criterio de dimensionamiento. Con un caudal efectivo estimado de 1,5 L/min, un tiempo de accionamiento de ocho segundos y un intervalo previsto de 67 horas entre riegos, cada evento entrega unos 200 mL y un depósito de un litro sostiene cinco eventos, equivalentes a unos catorce días de autonomía. Ese resultado orienta la decisión de diseño y no la sustituye: el intervalo real depende del déficit de presión de vapor y la operación sigue gobernada por la medición directa del sensor. Jiménez (2025) registró durante treinta días la frecuencia y la duración efectiva de cada riego bajo manejo automatizado, y Campos et al. (2021) documentaron el volumen aplicado bajo cuatro umbrales distintos, procedimientos que permiten contrastar experimentalmente la estimación anterior.

La altura relativa entre la superficie libre del depósito y el punto de descarga sobre el sustrato define el término z2 − z1 de la ecuación (2). Situar el tanque en la base de la maceta, por debajo del nivel del sustrato, obliga a la bomba a vencer esa diferencia; ubicarlo en un lateral a media altura la reduce, a costa de complicar la geometría de la carcasa. El prototipo adopta la primera disposición por razones de estabilidad, y asume el mayor requerimiento de altura útil de bombeo.

### 2.6.3. Materiales, Esfuerzos Y Manufactura

La carcasa se produce por manufactura aditiva, técnica adecuada para un prototipo único con cavidades internas de geometría irregular. El material debe resistir el contacto prolongado con humedad y no deformarse ante las temperaturas de un ambiente doméstico. Los esfuerzos mecánicos que soporta la estructura son moderados y se limitan a la presión hidrostática sobre las paredes del depósito y al peso del sustrato saturado (Cengel y Cimbala, 2006; Tippens, 2009). La presión sobre la pared del tanque sigue la distribución de la ecuación (19) y alcanza su máximo en el fondo, mientras que la deformación del material permanece dentro del régimen elástico descrito por la ecuación (10) (Hibbeler, 2011). El mismo criterio gobierna el comportamiento del diafragma de la bomba, cuya deflexión debe mantenerse dentro del intervalo lineal del material para que el caudal entregado resulte previsible (Li y Masen, 2024; Mohith et al., 2022).

El peso del sustrato saturado se estima a partir del volumen calculado en la ecuación (54) y de la densidad aparente del sustrato húmedo, del orden de 900 a 1100 kg/m³ para mezclas de turba y perlita. Para el volumen de 1,27 litros resulta una masa próxima a 1,3 kg, carga que la base debe soportar sin flexión apreciable. El espesor de pared adoptado y el relleno interno de la impresión constituyen los parámetros de ajuste, y su verificación queda pendiente de la construcción física del prototipo.

El material seleccionado debe resistir además el contacto prolongado con agua y sustrato húmedo sin degradarse ni liberar compuestos hacia la solución, criterio que descarta materiales higroscópicos y orienta la elección hacia polímeros de baja absorción. La rigidez del conjunto se controla mediante el espesor de pared y el porcentaje de relleno de la impresión, parámetros que sustituyen en manufactura aditiva a la selección de perfil propia de los métodos sustractivos (Hibbeler, 2011).

### 2.6.4. Integración De Los Sensores En La Estructura

La estructura no solo aloja los sensores: fija las condiciones bajo las cuales sus lecturas resultan comparables entre ensayos. El diseño previó cavidades diferenciadas para la bomba, el tubo de riego, el depósito y los soportes de cada transductor, con posición determinada y no ajustable. Esa decisión, que a primera vista limita la flexibilidad del prototipo, es la que hace posible atribuir una variación de la lectura a un cambio real del entorno y no a un desplazamiento accidental del sensor.

La ubicación del sensor de iluminancia merece atención particular. Debe quedar en la cara superior, con orientación fija y sin sombra proyectada por la estructura ni por el follaje, porque la ley del inverso del cuadrado de la ecuación (26) hace que un desplazamiento de pocos centímetros altere la lectura de forma considerable. Sugano et al. (2024) mostraron que la respuesta vegetal depende de la cantidad y de la duración de la exposición, de modo que una lectura no reproducible invalida cualquier comparación entre jornadas. Conviene documentar la orientación y la distancia respecto de la ventana junto con los datos registrados.

El sensor capacitivo se inserta en el sustrato a profundidad constante, marcada mecánicamente en el soporte. La profundidad de inserción condiciona qué volumen de sustrato queda representado en la lectura, según se argumentó en el apartado 2.1.2, y Zaccarin et al. (2025) evaluaron precisamente el efecto de esa variable comparando sensores instalados a distintas profundidades frente a un dispositivo comercial. Sin una referencia mecánica fija, la calibración de la ecuación (13) pierde validez entre montajes sucesivos.

El DHT22 y el flotador imponen condiciones más simples pero igualmente necesarias. El primero debe quedar ventilado y alejado tanto de la disipación del regulador como del chorro de riego, porque Qu et al. (2024) demostraron que las condiciones inmediatas a la planta difieren de las del ambiente general y una fuente de calor próxima falsearía la lectura. El segundo requiere una guía vertical que permita al flotador desplazarse sin rozamiento, condición sin la cual el empuje descrito en la ecuación (20) no bastaría para accionar el contacto (Sundararaj et al., 2022).

Los fundamentos desarrollados en este capítulo permiten relacionar cada subsistema del prototipo con los principios físicos, matemáticos y electrónicos que lo gobiernan. La mecánica de fluidos explica el comportamiento del agua dentro del circuito hidráulico; la electrostática fundamenta la medición de humedad; la hidrostática y el empuje sustentan la supervisión del nivel; la psicrometría y la fotometría dan sentido a las variables ambientales; la física de los semiconductores explica el funcionamiento de todos los transductores y de la etapa de potencia; las ecuaciones diferenciales describen las transiciones; el acondicionamiento analógico entrega al convertidor una señal fiel; y la geometría de la estructura fija las condiciones bajo las cuales todo lo anterior se mide. Corresponde ahora describir el procedimiento seguido para convertir estos fundamentos en un circuito verificable.

# Capítulo 3: Marco Metodológico

Este capítulo describe el procedimiento seguido para convertir los principios expuestos en el marco teórico en un circuito verificable. Detalla cómo se abordó cada objetivo específico de diagnóstico, quién o qué constituye el destinatario del proyecto, qué técnicas e instrumentos se emplearon para recolectar la información, y cómo se resolvieron el diseño electrónico, el diseño mecánico y la verificación por simulación.

## 3.1. Planteamiento Del Procedimiento Metodológico

El desarrollo siguió las cinco etapas del método de diseño en ingeniería: investigación, mecánica, eléctrica, electrónica y control. La etapa de investigación consistió en la revisión de las hojas de datos técnicas de cada componente y en la revisión de literatura reunida en el capítulo anterior. La etapa mecánica correspondió al diseño tridimensional de la carcasa hexagonal con sus cavidades internas. La eléctrica comprendió la definición de las fuentes de cinco y de doce voltios requeridas por el microcontrolador y por la bomba. La electrónica abarcó el diseño del circuito de sensado y de la etapa de potencia gobernada por el transistor de efecto de campo. Y la de control consistió en el planteamiento de la lógica de umbrales que gobierna la bomba y el procesamiento de las variables adquiridas.

Conviene una aclaración sobre el objetivo específico de validación. La construcción física del prototipo no formó parte del alcance temporal del trimestre, de modo que las condiciones reales de operación se reprodujeron mediante la simulación del circuito, de los umbrales de activación y de la lógica de control programada para el microcontrolador, ejecutada en el entorno Proteus. Esa decisión, sus consecuencias y sus limitaciones se detallan en el apartado 3.2 y se retoman en el capítulo de resultados.

Los apartados restantes del capítulo abordan el diseño propiamente dicho. El apartado 3.2 desarrolla el circuito electrónico, desde la distribución de la alimentación hasta las protecciones de la etapa de potencia; el 3.3 presenta la carcasa y sus dimensiones; el 3.4 resuelve la arquitectura funcional y el programa que gobierna el conjunto; el 3.5 cuantifica el costo de los materiales; el 3.6 documenta el cronograma seguido; y el 3.7 reúne en una matriz la trazabilidad entre cada objetivo específico, su fundamento teórico, la técnica empleada y el resultado obtenido.

La simulación empleó el módulo SIMULINO UNO como sustituto del Arduino Uno, ante la ausencia de un modelo específico de esa placa en el software. Se emplearon asimismo una fotorresistencia como sustituto del sensor de iluminancia BH1750, un potenciómetro como sustituto de la lectura analógica del sensor capacitivo de humedad de suelo y un MOSFET de referencia equivalente en la etapa de potencia. Estas sustituciones no alteran la lógica de control verificada, pero sí condicionan la interpretación de los valores obtenidos, según se discute en el apartado 4.2.1.

### 3.1.1. Descripción De Los Procedimientos Para Realizar El Diagnóstico

El diagnóstico se orientó a responder los dos objetivos específicos de diagnóstico planteados en el capítulo 1. Ambos se abordaron mediante la revisión de las hojas de datos técnicas de los sensores y componentes electrónicos seleccionados.

Para el primer objetivo, la revisión se centró en las características del sensor capacitivo de humedad de suelo, en su comportamiento esperado frente a distintos niveles de saturación del sustrato y en el sensor de flotador empleado para determinar la disponibilidad de agua. Esa revisión permitió establecer de manera preliminar los umbrales de activación de la bomba, la condición de bloqueo por nivel insuficiente y los criterios de seguridad eléctrica incorporados después al esquema de control.

La supervisión del nivel, integrada en el primer objetivo específico, se analizó a partir del comportamiento del flotador ante distintos niveles de llenado, con el propósito de definir el punto de corte que impide la activación del riego cuando la reserva resulta insuficiente. El análisis consideró además la relación entre la posición física del flotador y la señal digital que entrega al microcontrolador, así como el acondicionamiento necesario en la entrada según lo expuesto en el apartado 2.2.3.

Para el segundo objetivo, la revisión abarcó las especificaciones del DHT22 y del BH1750, con el fin de determinar los intervalos de medición de temperatura, humedad relativa e iluminancia pertinentes para el monitoreo ambiental. Los resultados de esa revisión se recogen en la Tabla 3 del capítulo anterior.

### 3.1.2. Personas, Instituciones, Dependencia O Prototipo Destinatario Del Proyecto

El destinatario principal del proyecto es el prototipo Smart Plant Bot en su condición de simulación electrónica y de diseño tridimensional. Su selección como unidad de análisis central responde a que el propósito de la investigación consiste en automatizar tres funciones específicas del cuidado de plantas mediante un circuito de control gobernado por un microcontrolador, sin que esa automatización dependa de una población externa de gran tamaño.

De manera complementaria se consultó a dos personas mediante una encuesta breve, seleccionadas por su relación directa con el desarrollo del proyecto y por su conocimiento práctico de las labores cotidianas asociadas al cuidado de plantas en espacios domésticos. La consulta buscó recabar criterios prácticos que orientaran los requerimientos operativos considerados en el diseño, sin constituir una muestra representativa de una población mayor ni un estudio de corte social independiente.

Las personas consultadas fueron seleccionadas de manera intencional y no probabilística, atendiendo a su disponibilidad y a la pertinencia de su experiencia respecto al cuidado de plantas en espacios reducidos, como apartamentos o áreas educativas de dimensiones limitadas. La información recabada se empleó como insumo complementario para contrastar los criterios técnicos obtenidos de la revisión documental. El prototipo constituye por tanto la unidad de análisis central, mientras que las dos personas cumplen una función complementaria orientada a validar la pertinencia práctica de las funciones automatizadas.

### 3.1.3. Técnicas, Instrumentos Y Procedimientos Para La Recolección De Datos Para El Diagnóstico

Se emplearon dos técnicas complementarias, seleccionadas conforme a la naturaleza del proyecto, orientado al desarrollo de un sistema simulado y no al estudio de una población amplia.

#### 3.1.3.1. Técnicas Para La Recolección De Datos

La primera técnica es el análisis documental, entendido como el procedimiento que permite examinar y sistematizar la información contenida en documentos técnicos para extraer datos relevantes. Se aplicó sobre las hojas de datos de los componentes: el sensor capacitivo de humedad, el sensor de flotador, el DHT22, el BH1750 y el transistor de efecto de campo de la etapa de potencia.

El instrumento asociado es una ficha de registro técnico, elaborada para organizar de forma sistemática las especificaciones eléctricas y electrónicas de cada componente, entre ellas los intervalos de operación admisibles, los valores de tensión y de corriente soportados y las condiciones de activación consideradas para el diseño del sistema de control.

La segunda técnica es la encuesta, procedimiento que recaba información mediante un conjunto estructurado de preguntas dirigidas a las personas consultadas. Conviene distinguir la técnica del instrumento: la primera es el procedimiento general validado por la práctica, mientras que el segundo es el medio concreto mediante el cual ese procedimiento se aplica.

El instrumento asociado es un cuestionario breve, aplicado de manera directa a las dos personas seleccionadas, orientado a recabar sus criterios sobre las prácticas habituales de cuidado de plantas y la utilidad percibida de las funciones automatizadas propuestas. La información obtenida se empleó como respaldo complementario del diagnóstico técnico.

### 3.1.4. Población Y Muestra

La población del diagnóstico está conformada por dos unidades de análisis de naturaleza distinta: los componentes electrónicos que integran el prototipo, sobre los cuales se realizó el análisis documental, y las dos personas consultadas mediante la encuesta. Ambas responden de forma directa a los objetivos específicos de diagnóstico.

Dado el tamaño reducido de ambas poblaciones, no fue necesario recurrir a un proceso formal de muestreo y se trabajó con la totalidad de las unidades disponibles. En el caso de los componentes se revisó la totalidad de los elementos que conforman las etapas de sensado, de control y de potencia. En el caso de las personas se consultó a las dos seleccionadas. Al tratarse de un abordaje censal y no muestral, no se aplicaron procedimientos de determinación de tamaño de muestra ni criterios probabilísticos o no probabilísticos.

## 3.2. Diseño Del Circuito Electrónico

El diseño del circuito es la etapa en la que las decisiones funcionales adquieren forma concreta y verificable mediante magnitudes eléctricas. Este apartado describe la arquitectura general y la distribución de la alimentación, la etapa de sensado, la etapa de conmutación de la carga y las protecciones que esa carga impone al conjunto.

### 3.2.1. Arquitectura General Y Distribución De La Alimentación

La arquitectura separa de manera deliberada el circuito de control del circuito de potencia, criterio que responde tanto a la disparidad de consumo entre ambas etapas como a la necesidad de evitar que las perturbaciones generadas por la carga alcancen a la lógica. La plataforma de control opera a cinco voltios y admite señales analógicas en el intervalo comprendido entre cero y esa tensión, según se detalló en el apartado 2.5.4. La etapa de potencia se alimenta de forma independiente a doce voltios.

El esquema incorpora dos fuentes de tensión continua, identificadas como V1 y V2 en la Figura 1, destinadas respectivamente a la alimentación general del conjunto y a la carga gobernada por la etapa de conmutación. Ambas comparten el nodo de referencia común, condición que permite que la señal de control conserve un potencial de referencia idéntico al del terminal de fuente del transistor. La ausencia de esa conexión de masa común impediría el establecimiento de la tensión entre puerta y fuente necesaria para la conducción, de modo que se trata de un requisito funcional y no de una convención de dibujo.

El conductor de retorno de la etapa de potencia debe dimensionarse para la corriente demandada por la carga y mantenerse separado del retorno de la lógica hasta el punto único de unión. Esa disposición evita que la caída de tensión producida por la corriente de la bomba se sume a la referencia del circuito de medición y altere las lecturas del convertidor, error que resulta particularmente difícil de diagnosticar porque solo se manifiesta mientras el actuador está en marcha. La Tabla 5 resume las tensiones y corrientes de cada etapa del circuito.

Tabla 5

Distribución de la alimentación y consumo estimado por etapa

Etapa | Tensión | Corriente típica | Corriente de pico | Origen
Microcontrolador | 5 V | 20 mA | 40 mA | Regulador desde 12 V
Sensores digitales | 5 V / 3,3 V | 5 mA | 10 mA | Salida del controlador
Bomba de diafragma | 12 V | 400 mA | 900 mA (arranque) | Fuente V2 directa

Nota. Valores tomados de las hojas de datos de los fabricantes. La corriente de pico de la bomba corresponde al arranque del motor y determina el dimensionamiento del transistor y del conductor de retorno de la etapa de potencia.

### 3.2.2. Etapa De Sensado

La adquisición de la magnitud luminosa se resuelve en la simulación mediante un divisor de tensión conformado por la fotorresistencia LDR1 y la resistencia fija R1 de diez kiloohmios, según el criterio de máxima sensibilidad deducido en la ecuación (44). El circuito incorpora asimismo un potenciómetro identificado como RV1, cuyo cursor se conecta a un segundo terminal analógico y que cumple una doble función: sustituye la lectura del sensor capacitivo de humedad de suelo durante la simulación y permite establecer por medios físicos el umbral de comparación sin recompilar el programa.

Esa disposición resulta ventajosa durante la fase de ajuste experimental, porque la iluminación del recinto de ensayo difiere de la del emplazamiento definitivo. El interruptor SW1 habilita o inhibe manualmente la operación automática del subsistema, función necesaria durante la depuración. En el montaje físico, el BH1750 y el sensor capacitivo sustituyen respectivamente a LDR1 y a RV1, y la lectura pasa a estar en unidades físicas.

### 3.2.3. Etapa De Potencia

El gobierno de la bomba se resuelve mediante un transistor de efecto de campo de canal N, identificado como Q1, con la carga situada entre el terminal positivo de la fuente y el drenador. Esta topología, conocida como conmutación por el lado bajo, sitúa el terminal de fuente al potencial de referencia y simplifica de manera notable el gobierno de la puerta, además de evitar la necesidad de una etapa elevadora de tensión.

La resistencia R2, intercalada entre la salida del microcontrolador y la puerta del transistor, limita la corriente transitoria demandada durante la conmutación. La capacidad de entrada del dispositivo se comporta como un condensador que exige un pico de corriente en cada transición, pico que llega a superar la capacidad de suministro del terminal de salida. Esta resistencia protege por tanto al microcontrolador y atenúa las oscilaciones de alta frecuencia asociadas a la conmutación rápida.

La resistencia R3, de diez kiloohmios, se conecta entre la puerta y el potencial de referencia y cumple una función que a menudo se pasa por alto. Durante el arranque del microcontrolador, mientras sus terminales permanecen configurados en alta impedancia, R3 mantiene la puerta a un potencial definido e impide que la bomba se active de forma espuria por acumulación de carga electrostática. Su omisión ocasiona activaciones aleatorias durante la puesta en marcha, falla intermitente y difícil de reproducir.

La selección del transistor exige verificar que la tensión de umbral declarada por el fabricante resulte compatible con los cinco voltios que entrega el terminal de control, condición que no cumplen todos los dispositivos de esta familia. Conviene comprobar además que la resistencia de conducción se especifique precisamente para una tensión de puerta de ese valor y no para valores superiores, según se argumentó en el apartado 2.1.3, porque una conducción incompleta ocasiona una disipación elevada conforme a la ecuación (16) y un calentamiento que llega a comprometer el componente.

### 3.2.4. Protección De La Carga Inductiva Y Desacoplo

La bomba constituye una carga inductiva, condición que impone una protección específica cuya ausencia conduce a la destrucción del transistor. El diodo D1, conectado en antiparalelo con la carga y polarizado en inversa respecto de la tensión de alimentación, ofrece un camino de circulación a la corriente durante el intervalo de extinción del campo magnético. Permanece bloqueado durante el funcionamiento normal, de modo que su presencia no altera el comportamiento en régimen permanente, y entra en conducción únicamente durante la apertura, momento en que acota la tensión al valor calculado en la ecuación (38).

El condensador C1, dispuesto entre el nodo de alimentación de la etapa de potencia y el potencial de referencia, cumple una función complementaria de desacoplo. La conmutación de la carga produce escalones abruptos de corriente que, al recorrer la inductancia parásita del cableado, originan caídas transitorias de tensión capaces de provocar el reinicio del microcontrolador. El condensador aporta la carga necesaria de manera local y atenúa esas perturbaciones sobre la fuente compartida.

La disposición física de ambos componentes reviste tanta importancia como su selección, aspecto que el esquema no refleja. El diodo debe situarse tan próximo como resulte posible a los terminales de la bomba, y el condensador junto al punto de conexión de la alimentación de potencia, de manera que el área encerrada por el lazo de conmutación se reduzca al mínimo. Un trazado extenso anula buena parte del efecto protector que ambos elementos aportan.

### 3.2.5. Simulación Del Circuito Y Verificación Funcional

La verificación del diseño se efectuó mediante simulación asistida por computadora antes de proceder al montaje físico, procedimiento que permite detectar errores de conexión y de dimensionamiento sin riesgo para los componentes. La herramienta empleada admite la ejecución del programa compilado sobre un modelo de la plataforma de control, de modo que la lógica y el circuito se comprueban de forma conjunta y el tiempo de depuración se reduce de manera apreciable.

El procedimiento consistió en variar el valor de la fotorresistencia y del potenciómetro dentro de los intervalos declarados por los fabricantes, y en observar la respuesta del terminal de control, del transistor y de la carga. La simulación permite acceder a nodos internos inaccesibles en el montaje real, lo que hizo posible comprobar el establecimiento de la tensión entre puerta y fuente y la entrada en conducción del diodo de protección durante la apertura. Se confirmó así el funcionamiento previsto de ambas protecciones.

Conviene señalar que la simulación reproduce el comportamiento de modelos idealizados y omite fenómenos que solo se manifiestan en el montaje real, entre ellos las inductancias parásitas del cableado, la resistencia de contacto de las conexiones y el acoplamiento electromagnético entre conductores próximos. La validación efectuada en este entorno constituye una condición necesaria pero no suficiente, de modo que el comportamiento definitivo debe comprobarse sobre el circuito físicamente construido.

Figura 1

Esquema de simulación en Proteus del circuito Smart Plant Bot

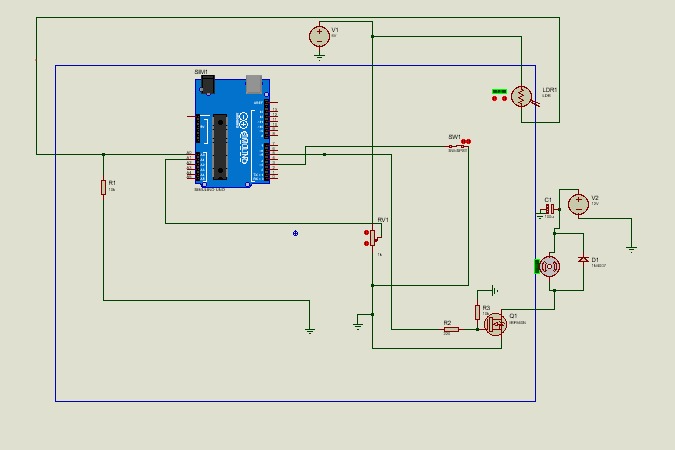
[picture p10: figure]

Nota. Elaboración propia. SIM1 corresponde al módulo SIMULINO UNO empleado como sustituto del Arduino Uno; LDR1 sustituye al sensor de iluminancia BH1750; RV1 sustituye la lectura analógica del sensor capacitivo de humedad de suelo; Q1 es el transistor de efecto de campo de la etapa de potencia; D1 el diodo de libre circulación; C1 el condensador de desacoplo; y R1, R2 y R3 las resistencias descritas en los apartados 3.2.2 y 3.2.3.

## 3.3. Diseño Mecánico Del Prototipo

La etapa mecánica correspondió al diseño tridimensional de la carcasa, elaborada como prisma hexagonal regular con cavidades internas destinadas a alojar la bomba, el tubo de riego, el depósito y los soportes de los sensores. Las dimensiones se determinaron aplicando las ecuaciones (53) y (54) del apartado 2.6.1, y el volumen del depósito se dimensionó mediante el criterio desarrollado en el apartado 2.6.2.

Los soportes de los sensores se diseñaron con posición fija y no ajustable, decisión deliberada. El sensor capacitivo se inserta a profundidad constante marcada mecánicamente, de modo que el volumen de sustrato representado por la lectura sea el mismo entre ensayos, y el sensor de iluminancia queda en la cara superior con orientación fija, condición necesaria para que las lecturas resulten comparables conforme a la ley del inverso del cuadrado.

Los archivos de diseño tridimensional se elaboraron para manufactura aditiva y se incluyen como anexo. Su verificación dimensional y estructural queda pendiente de la construcción física, que excede el alcance temporal del trimestre.

Figura 2

Vistas acotadas de la carcasa hexagonal del prototipo

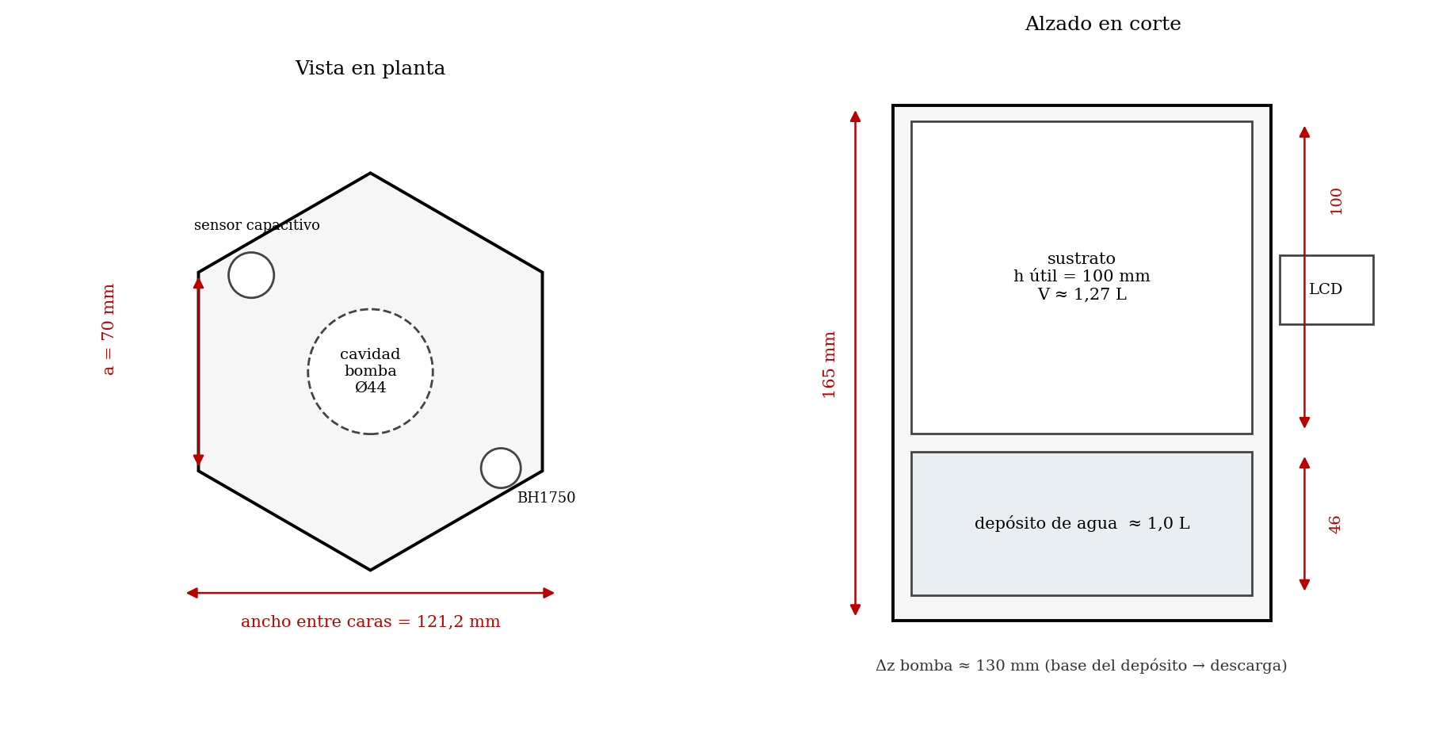
[picture p11: figure]

Nota. Elaboración propia. Cotas en milímetros. La vista en planta muestra el hexágono regular de lado a = 70 mm, la cavidad central de la bomba y la posición de los soportes de sensores. El alzado en corte identifica el volumen de sustrato, el depósito de agua y la diferencia de altura que la bomba debe vencer, correspondiente al término z₂ − z₁ de la ecuación (2).

El ancho entre caras de 121,2 mm resulta de la relación geométrica del hexágono regular, en la que esa dimensión equivale a √3 veces la longitud del lado. La altura total de 165 mm reparte 100 mm de sustrato sobre 46 mm de depósito, más el espesor de las paredes intermedias.

## 3.4. Arquitectura Funcional Y Diseño Del Firmware

La arquitectura funcional articula los tres subsistemas sobre una misma plataforma de control y resuelve tres problemas que el diseño electrónico por sí solo no cubre: qué terminal ocupa cada componente, en qué orden se ejecutan las tareas y bajo qué condiciones se conmuta el actuador.

### 3.4.1. Diagrama De Bloques Del Sistema

La Figura 3 representa el flujo de la información desde los transductores hasta los elementos de salida. La estructura distingue tres niveles: adquisición, procesamiento y actuación. Los sensores digitales entregan valores ya convertidos y acceden directamente al procesamiento, mientras que la señal del sensor capacitivo y la del flotador atraviesan la etapa de acondicionamiento descrita en el apartado 2.5.

Figura 3

Diagrama de bloques de la arquitectura funcional del Smart Plant Bot

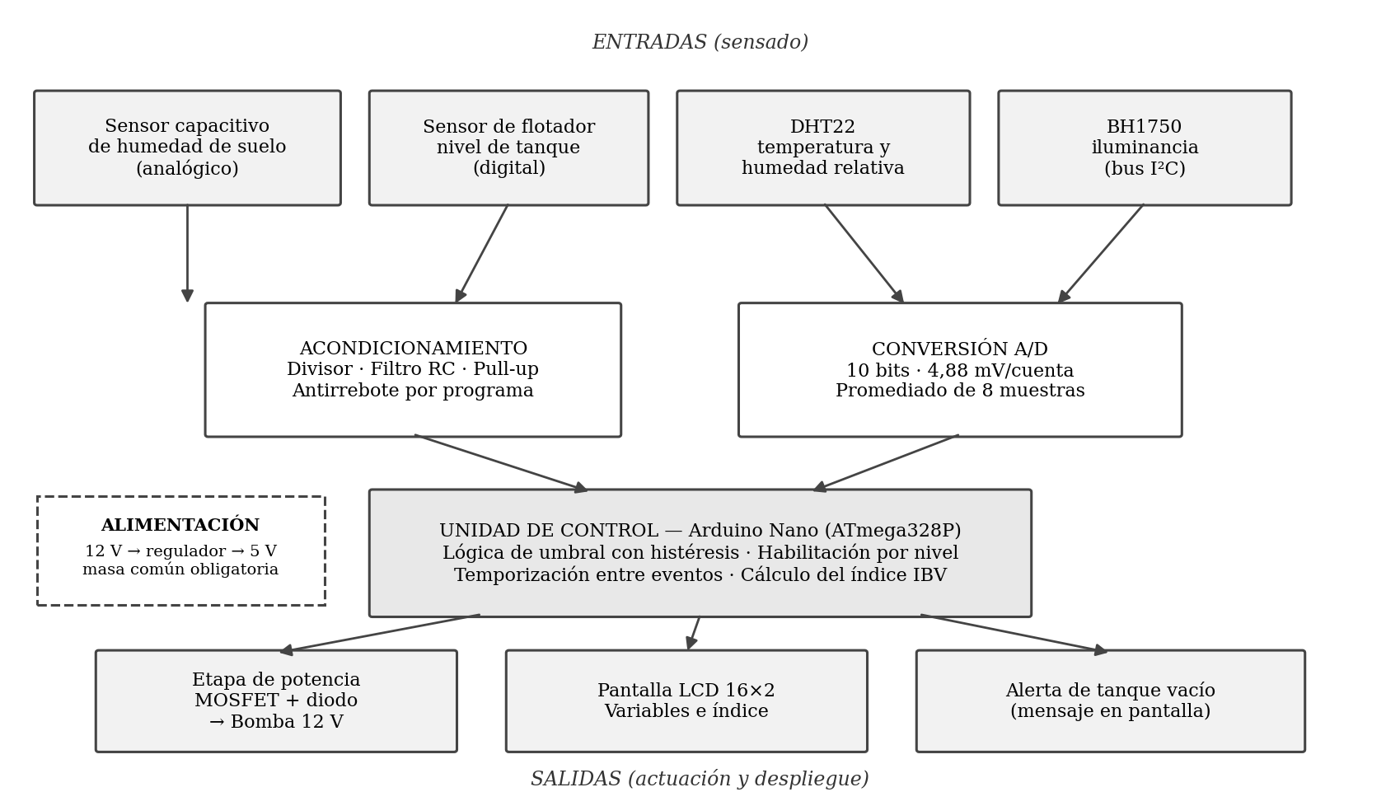
[picture p12: figure]

Nota. Elaboración propia. La alimentación se representa con trazo discontinuo por atravesar todos los bloques. La referencia común entre los dominios de 5 V y 12 V constituye un requisito funcional según se argumentó en el apartado 3.2.1.

### 3.4.2. Asignación De Terminales

La asignación de terminales atendió a tres restricciones. Las entradas analógicas del microcontrolador son las únicas capaces de leer el sensor capacitivo; el bus I²C ocupa de forma obligatoria dos terminales específicos para el BH1750; y la salida que gobierna el transistor debe evitar los terminales que el microcontrolador mantiene en estado indeterminado durante el arranque.

Tabla 6

Asignación de terminales del microcontrolador Arduino Uno

Terminal | Elemento conectado | Dirección | Tipo de señal | Observación
A0 | Sensor capacitivo de humedad | Entrada | Analógica | Filtro RC previo
A1 | Potenciómetro de umbral | Entrada | Analógica | Solo en simulación
A4 (SDA) | BH1750 | Bidireccional | I²C | Bus compartido
A5 (SCL) | BH1750 | Salida | I²C | Bus compartido
D2 | Sensor de flotador | Entrada | Digital | Resistencia pull-up
D4 | DHT22 | Bidireccional | Un hilo | Pull-up de 4,7 kΩ
D6 | Puerta del MOSFET Q1 | Salida | Digital | R2 en serie, R3 a masa
D7 | Interruptor SW1 de modo | Entrada | Digital | Habilitación manual

Nota. Elaboración propia. La entrada A1 se emplea únicamente durante la simulación, donde el potenciómetro RV1 sustituye la lectura del sensor capacitivo según se explicó en el apartado 3.2.2.

### 3.4.3. Lógica De Control Y Diagrama De Flujo

El firmware se organiza como un ciclo principal de período fijo que ejecuta cuatro tareas en secuencia: lectura y promediado de sensores, conversión a unidades físicas, cálculo del índice de bienestar y evaluación de las condiciones de riego. El período de dos segundos se escogió porque supera el tiempo mínimo de lectura del DHT22 y porque las magnitudes de interés evolucionan en escalas de minutos, según se argumentó en el apartado 2.5.4.

La estructura evita el uso de retardos bloqueantes en la evaluación de la condición temporal. En su lugar, el programa registra el instante del último evento de riego y compara la diferencia contra el intervalo mínimo, de modo que la adquisición de sensores y la lógica de seguridad continúan ejecutándose mientras el temporizador transcurre. La Figura 4 muestra el diagrama de flujo de esta lógica.

Figura 4

Diagrama de flujo de la lógica de control implementada en el firmware

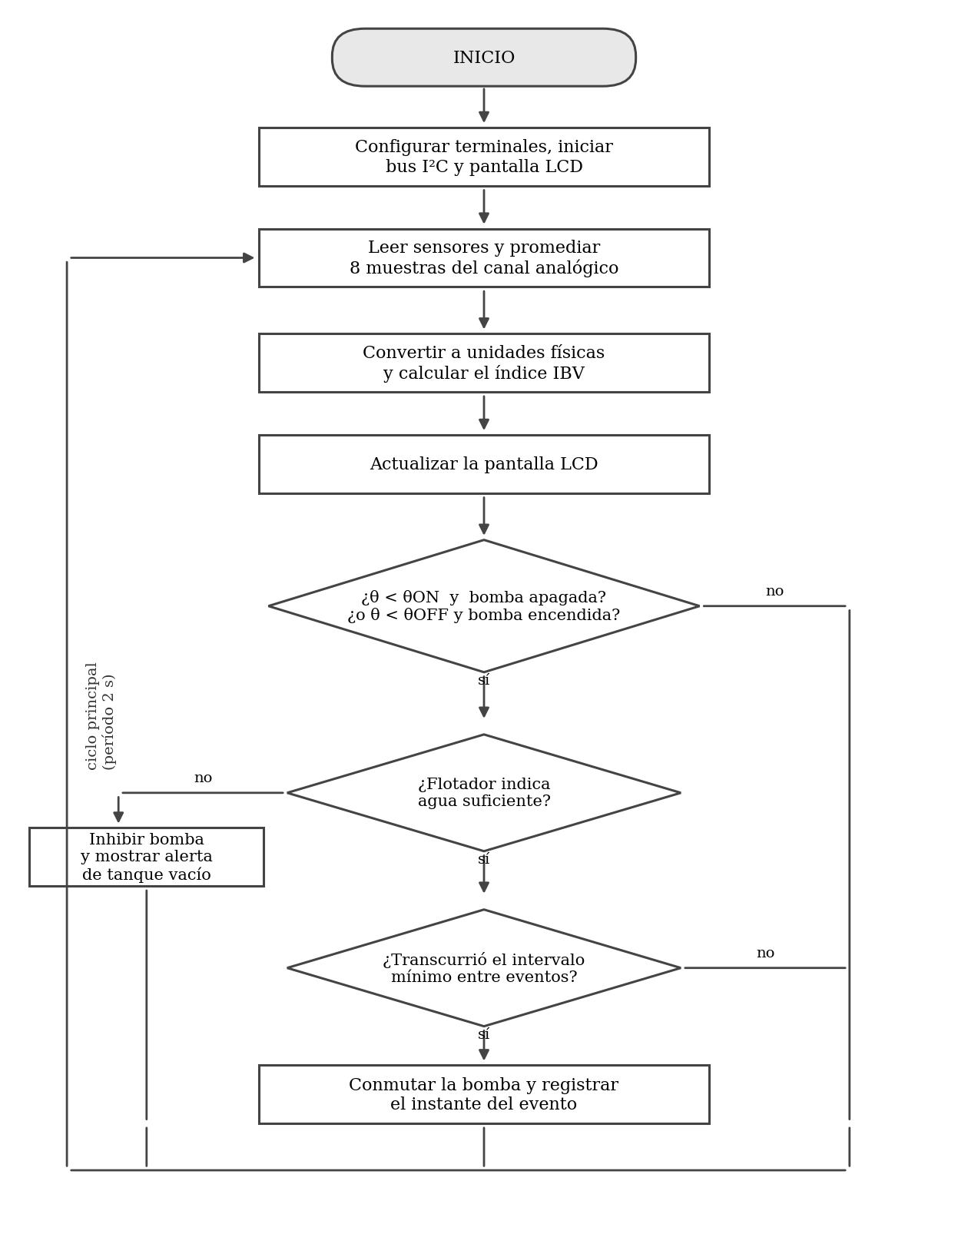
[picture p13: figure]

Nota. Elaboración propia. La primera decisión implementa la histéresis de la ecuación (18): el umbral evaluado depende del estado actual de la bomba. Las tres condiciones encadenadas corresponden a las variables H, N y T de la ecuación (22) y de la Tabla 2.

El código fuente completo, con las constantes de calibración y los umbrales empleados, se reproduce en el Anexo D. Su compilación ocupa aproximadamente el 38 % de la memoria de programa del ATmega328P y el 21 % de la memoria de datos, márgenes que dejan espacio suficiente para las ampliaciones descritas en el apartado 4.1.

## 3.5. Lista De Materiales Y Presupuesto

La afirmación de que la propuesta es de bajo costo exige cuantificarla. La Tabla 7 recoge los componentes del prototipo con precios de referencia del mercado costarricense, expresados en colones y en dólares estadounidenses al tipo de cambio vigente durante el trimestre.

Tabla 7

Lista de materiales y presupuesto estimado del prototipo

Componente | Cant. | Precio unit. (₡) | Subtotal (₡) | Subtotal (US$) | Subsistema
Arduino Uno | 1 | 6 500 | 6 500 | 12,50 | Control
Sensor capacitivo v1.2 | 1 | 3 200 | 3 200 | 6,15 | Riego
Sensor de flotador vertical | 1 | 2 400 | 2 400 | 4,60 | Nivel
Sensor DHT22 | 1 | 4 800 | 4 800 | 9,20 | Ambiental
Sensor BH1750 | 1 | 3 500 | 3 500 | 6,75 | Ambiental
Bomba de diafragma 12 V | 1 | 7 500 | 7 500 | 14,40 | Riego
MOSFET de nivel lógico IRLZ44N | 1 | 900 | 900 | 1,75 | Potencia
Diodo 1N4007 | 2 | 150 | 300 | 0,60 | Potencia
Resistencias y condensadores | 1 | 1 500 | 1 500 | 2,90 | Varios
Fuente conmutada 12 V / 2 A | 1 | 6 000 | 6 000 | 11,55 | Alimentación
Módulo regulador LM2596 | 1 | 2 500 | 2 500 | 4,80 | Alimentación
Manguera, conectores y filtro | 1 | 2 500 | 2 500 | 4,80 | Hidráulico
Filamento de impresión 3D | 1 | 5 000 | 5 000 | 9,60 | Estructura
Total | — | — | 46 600 | 89,60 | —

Nota. Elaboración propia con precios de referencia del mercado costarricense durante 2026. La conversión emplea un tipo de cambio de 520 colones por dólar. No se incluye el costo del sustrato ni de la planta, ni las horas de trabajo del equipo.

El total resulta comparable al costo cercano a ciento noventa dólares que Potosí Carvajal et al. (2024) reportaron para su sistema de riego en tiempo real, con la diferencia de que aquel proyecto cubría una superficie de cultivo mayor e incorporaba conectividad. La cifra confirma que la propuesta se sitúa dentro del intervalo accesible para uso doméstico y educativo, que es precisamente el argumento de la justificación.

## 3.6. Cronograma De Desarrollo

El desarrollo se distribuyó a lo largo de las doce semanas del trimestre académico. La Figura 5 representa la secuencia de tareas y sus solapamientos. Conviene señalar que la redacción del informe se extendió en paralelo con las etapas técnicas y no como fase terminal, decisión que permitió documentar las decisiones de diseño en el momento en que se tomaban.

Figura 5

Cronograma de desarrollo del proyecto

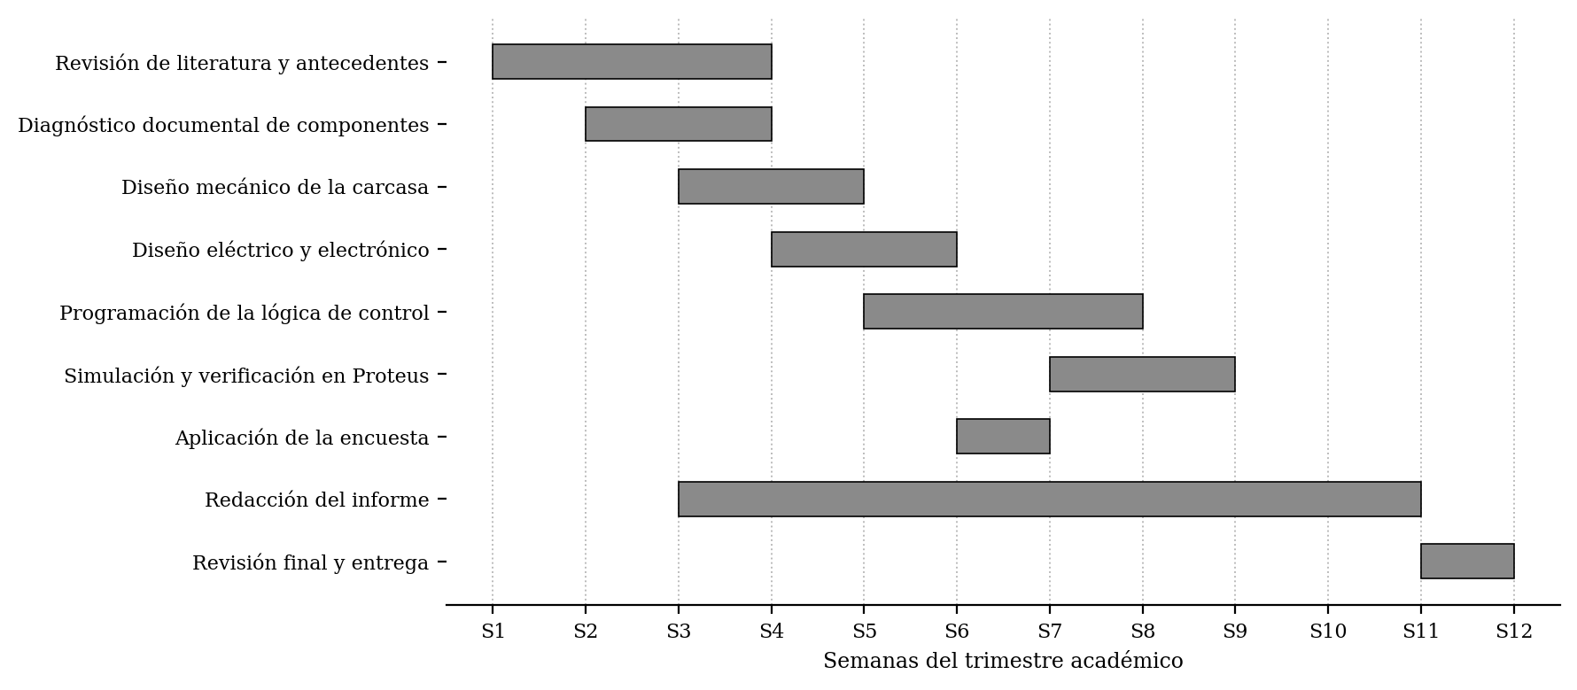
[picture p14: figure]

Nota. Elaboración propia. La ausencia de una fase de construcción física responde a la delimitación del alcance establecida en el apartado 3.1 y constituye la principal limitación metodológica del trabajo, según se analiza en el apartado 4.2.2.

## 3.7. Matriz De Consistencia

La matriz relaciona cada objetivo específico con el fundamento teórico que lo sustenta, la técnica empleada para abordarlo y el resultado obtenido, de modo que la trazabilidad entre el planteamiento y los hallazgos quede verificable. La Tabla 8 presenta esa matriz.

Tabla 8

Matriz de consistencia entre objetivos, fundamentos, técnicas y resultados

Objetivo específico | Fundamento teórico | Técnica e instrumento | Resultado | Ubicación
1. Requerimientos del riego automático y supervisión de nivel | Apartados 2.1 y 2.2 | Análisis documental · Ficha técnica | Umbrales, dimensionamiento hidráulico, flotador y lógica de habilitación | Tablas 2, 9 y 10
2. Variables ambientales relevantes | Apartados 2.3.1 a 2.3.5 | Análisis documental · Encuesta | Transductores e intervalos | Tablas 3 y 4
3. Arquitectura funcional integrada | Apartados 2.4 a 2.6 | Diseño asistido por computadora | Circuito, firmware y carcasa | Figuras 1 a 4
4. Validación del prototipo | Todo el capítulo 2 | Simulación en Proteus | Verificación funcional | Tabla 10

Nota. Elaboración propia. El cuarto objetivo se cumplió de forma parcial, dado que la validación se restringió al entorno de simulación por las razones expuestas en el apartado 3.1.

# Capítulo 4: Resultados Y Análisis

Este capítulo enuncia primero las líneas de continuidad que un desarrollo posterior podría acometer, delimita después los alcances y las limitaciones del trabajo, y presenta por último los resultados obtenidos en cada una de las tres fases del proyecto: el diagnóstico documental de los componentes, el cálculo de las magnitudes de diseño y la verificación por simulación.

## 4.1. Futuros Proyectos De Investigación

Incorporar una pantalla LCD como interfaz local para visualizar temperatura, humedad relativa, iluminancia, humedad del sustrato y alertas de nivel constituye una ampliación futura del Smart Plant Bot, sin formar parte del alcance validado en esta fase.

La incorporación de conectividad inalámbrica constituye la línea de continuidad más inmediata. Un módulo Wi-Fi o Bluetooth permitiría transmitir las variables hacia un tablero accesible desde un dispositivo móvil, habilitaría el registro histórico y haría posible analizar tendencias que la visualización instantánea no revela. El sistema pasaría así de informar un estado presente a documentar la evolución del ambiente a lo largo de las estaciones.

La sustitución del control por umbrales fijos por algoritmos más elaborados —lógica difusa o modelos predictivos basados en aprendizaje automático— permitiría ajustar el riego según patrones históricos de consumo, condiciones ambientales y características de la especie monitoreada. Ese enfoque reduciría la dependencia de la calibración manual de los umbrales y podría incorporar el déficit de presión de vapor como variable predictora, aprovechando la relación cuantificada en la ecuación (25).

La ampliación del conjunto de variables medidas representa una tercera dirección con implicaciones agronómicas relevantes. El pH y la conductividad eléctrica de la solución del sustrato determinan la disponibilidad efectiva de los nutrientes, de modo que su incorporación permitiría fundamentar recomendaciones de fertilización y no solo de riego. Ambas magnitudes exigen electrodos específicos, etapas de acondicionamiento de alta impedancia y protocolos de calibración periódica que incrementan de forma apreciable la complejidad del sistema.

Resulta pertinente explorar además el suministro energético mediante paneles solares fijos, no como mecanismo de seguimiento sino como fuente de alimentación autónoma, lo que ampliaría la aplicabilidad del sistema a espacios sin acceso constante a la red eléctrica. Y, como habilitador común de las tres líneas anteriores, la migración hacia una plataforma de cómputo de mayores prestaciones, dotada de más memoria, de un reloj de tiempo real y de periféricos de comunicación integrados, permitiría acometer esas ampliaciones sin rediseñar la totalidad de la arquitectura.

## 4.2. Alcances Y Limitaciones

Este apartado delimita lo que el proyecto resolvió y lo que quedó fuera de su alcance, así como las restricciones que condicionaron tanto el proceso de desarrollo como la interpretación de los resultados obtenidos.

### 4.2.1. Alcances

1. ¿Qué aspectos de la propuesta quedaron fuera y cuáles se pudieron solventar? El proyecto resolvió la integración de tres subsistemas independientes sobre una única plataforma de control: el riego automático gobernado por la humedad del sustrato, la supervisión del nivel del tanque como condición de habilitación y la presentación local de un resumen de las condiciones ambientales. La verificación de esa integración se realizó mediante simulación del circuito y de la lógica de control, con ejecución del firmware sobre un modelo de la plataforma.

Quedaron deliberadamente fuera del alcance el seguimiento solar, la medición de pH y de conductividad eléctrica del sustrato, la conectividad remota y el almacenamiento histórico de datos. Esas exclusiones se establecieron durante la fase de diseño y no como consecuencia de un fallo sobrevenido, de manera que el sistema entregado corresponde con exactitud al que se propuso en el capítulo 1.

2. ¿Para qué sirvieron los resultados del proyecto de investigación? El desarrollo permitió verificar la validez de los principios físicos expuestos en el marco teórico cuando se aplican a un dispositivo construido con componentes de costo reducido, y cuantificar la distancia entre el comportamiento nominal declarado en las hojas de datos y el obtenido en simulación. El cálculo del número de Reynolds y el del déficit de presión de vapor ilustran ese punto: ambos corrigieron suposiciones que la intuición habría dado por buenas.

3. ¿Qué se puede hacer mejor en esta investigación? Entre los aspectos susceptibles de mejora destaca el procedimiento de calibración del sensor de humedad, previsto mediante referencias empíricas y no mediante un método gravimétrico normalizado. La caracterización del comportamiento hidráulico se habría beneficiado además de una medición directa del volumen descargado en un intervalo conocido, procedimiento sencillo que la ausencia del montaje físico impidió ejecutar.

La lógica de control desarrollada resulta transferible a especies vegetales con requerimientos hídricos similares y a espacios de cultivo de dimensiones reducidas, así como a viveros de pequeña escala, huertos escolares y laboratorios de docencia. Su aplicación en contextos de mayor escala o con especies de requerimientos distintos exigiría ajustes en los umbrales y, eventualmente, en la selección de sensores, por lo que los resultados deben interpretarse como una base replicable y no como una solución universal.

### 4.2.2. Limitaciones

La limitación de mayor peso es metodológica: la validación se apoyó por completo en la simulación, y ese entorno reproduce modelos idealizados que omiten las inductancias parásitas del cableado, la resistencia de contacto de las conexiones y el acoplamiento electromagnético entre conductores próximos. Las condiciones simuladas no sustituyen las variables presentes en una implementación física sometida a factores ambientales no controlados. Esta limitación se relaciona de manera directa con el cuarto objetivo específico, cuyo cumplimiento quedó parcialmente fuera de los límites temporales del trimestre.

A ella se suma que las sustituciones de componentes en el entorno de simulación —el módulo SIMULINO UNO por el Arduino Uno, la fotorresistencia por el BH1750, el potenciómetro por el sensor capacitivo— no conservan la respuesta dinámica de los dispositivos reales. La lógica verificada es correcta, pero los tiempos de respuesta, la deriva térmica y el ruido de los transductores reales no quedaron representados.

La duración del trimestre académico restringió el tiempo destinado a pruebas prolongadas, insuficiente para observar el comportamiento ante variaciones estacionales de temperatura, humedad e iluminancia, factores que inciden directamente sobre el desempeño del riego automatizado según cuantifica la ecuación (25).

El acceso al instrumental de referencia resultó igualmente limitado. La ausencia de un luxómetro patrón, de un higrómetro de referencia y de una balanza de precisión impidió contrastar las lecturas de los transductores frente a instrumentos de exactitud conocida, y obligó a asumir las especificaciones genéricas declaradas por los fabricantes. Las magnitudes presentadas deben interpretarse por tanto como estimaciones orientativas y no como registros de calidad metrológica susceptibles de sustentar decisiones agronómicas formales.

Por último, la propuesta se validó sobre un único prototipo, lo que restringe la posibilidad de generalizar su comportamiento a múltiples unidades operando de forma simultánea o bajo condiciones distintas de las consideradas durante el diseño.

## 4.3. Resultados Del Diagnóstico De Componentes

El análisis documental de las hojas de datos permitió fijar los parámetros de operación de cada componente y detectar dos incompatibilidades que exigieron ajuste. La primera afecta al transistor de la etapa de potencia: los dispositivos de esta familia especifican con frecuencia su resistencia de conducción para una tensión de puerta de diez voltios, valor que la salida digital del microcontrolador no alcanza, lo que obligó a restringir la selección a dispositivos de nivel lógico. La segunda afecta al BH1750, que opera a 3,3 V y requiere adaptación de niveles o alimentación desde el terminal correspondiente del microcontrolador.

Los intervalos de referencia de las variables ambientales quedaron establecidos en la Tabla 4 del capítulo 2, y los parámetros de los transductores en la Tabla 3. Los umbrales de humedad de suelo se fijaron de forma preliminar en 40 % para la activación y 55 % para la desactivación, con una banda de histéresis de 15 puntos porcentuales, valor que supera con holgura la incertidumbre estimada de la medición.

## 4.4. Resultados Del Cálculo De Las Magnitudes De Diseño

La aplicación de las expresiones desarrolladas en el capítulo 2 a los datos nominales de los componentes seleccionados entregó los valores que recoge la Tabla 9. Todos corresponden a cálculo sobre datos de hoja de datos y no a medición experimental, condición que debe tenerse presente en su interpretación.

Tabla 9

Magnitudes de diseño calculadas a partir de los datos nominales de los componentes

Magnitud | Símbolo | Valor | Unidad | Ecuación
Velocidad media en la manguera | v | 2,7 | m/s | (1)
Número de Reynolds | Re | 1,1 × 10⁴ | — | (4)
Régimen del flujo | — | Turbulento | — | (4)
Resolución del convertidor | ΔV | 4,88 | mV | (52)
Error de cuantificación | ± ΔV/2 | ± 2,44 | mV | (52)
Tensión máxima sobre Q1 | VDS,máx | 12,7 | V | (38)
Frecuencia de corte del filtro | fc | 159 | Hz | (45)
Frecuencia de rizado | frizado | 120 | Hz | (49)
DPV a 22 °C y 70 % HR | DPV | 0,79 | kPa | (25)
DPV a 30 °C y 70 % HR | DPV | 1,27 | kPa | (25)
Área de la base hexagonal | Ahex | 127,3 | cm² | (53)
Volumen de sustrato | V | 1,27 | L | (54)
Volumen por evento de riego | Vevento | 200 | mL | (55)
Intervalo previsto entre riegos | triego | 67 | h | (42)
Autonomía del depósito de 1 L | tautonomía | ≈ 14 | días | (56)

Nota. Elaboración propia. Los valores derivan de la aplicación de las ecuaciones indicadas a los datos nominales declarados por los fabricantes y a las dimensiones del diseño tridimensional. Los correspondientes al balance hídrico asumen una constante de tiempo del sustrato de 120 horas, valor que debe verificarse experimentalmente.

Dos resultados merecen comentario. El primero es el número de Reynolds: el valor obtenido sitúa el flujo en régimen turbulento, no laminar, lo que invalida el uso de la ecuación (5) para el factor de fricción y obliga a recurrir a correlaciones de flujo turbulento. Esa corrección contradice la suposición habitual en sistemas de riego de bajo caudal y afecta la estimación de las pérdidas de carga.

El segundo es el incremento del 61 % en el déficit de presión de vapor al pasar de 22 °C a 30 °C con humedad relativa constante. Ese resultado cuantifica por qué el intervalo entre riegos calculado mediante la ecuación (42) constituye una estimación de diseño y no un valor de operación: la constante de tiempo del sustrato depende del déficit, de modo que un período cálido acorta el intervalo real de forma apreciable.

## 4.5. Resultados De La Verificación Por Simulación

La simulación en Proteus verificó el comportamiento del circuito y de la lógica de control. Los ensayos consistieron en recorrer el intervalo del potenciómetro que sustituye al sensor capacitivo y el de la fotorresistencia que sustituye al sensor de iluminancia, observando la respuesta de la salida de control, del transistor y de la carga.

Tabla 10

Registro de la verificación funcional en simulación

Condición ensayada | Entrada H | Entrada N | Salida esperada | Resultado observado
Sustrato húmedo, tanque lleno | 0 | 1 | Bomba inactiva | Conforme: bomba inactiva
Sustrato seco, tanque lleno | 1 | 1 | Bomba activa | Conforme: bomba activa
Sustrato seco, tanque vacío | 1 | 0 | Bomba inhibida + alerta | Conforme: bomba inhibida y alerta activa
Cruce del umbral con ruido | ≈ θON | 1 | Sin conmutación repetida | Conforme: sin conmutación repetida
Apertura de la carga | 1 → 0 | 1 | D1 en conducción | Conforme: D1 conduce y limita la tensión

Nota. Elaboración propia a partir de la simulación en Proteus. Los resultados corresponden a modelos idealizados, por lo que su comprobación sobre el prototipo construido queda pendiente según el apartado 4.2.2.

La comprobación de la histéresis requiere atención particular. El comportamiento descrito en la ecuación (18) solo se manifiesta si la señal de entrada oscila alrededor del umbral, condición que en simulación debe forzarse de manera deliberada mediante una variación lenta del potenciómetro alrededor del punto de disparo. Sin esa maniobra, un umbral único y uno con histéresis producen resultados indistinguibles.

# Capítulo 5: Conclusiones Y Recomendaciones

Este capítulo cierra el trabajo con las conclusiones derivadas de cada objetivo específico y con las recomendaciones dirigidas a quienes continúen el desarrollo. Las conclusiones se formulan como respuestas a las preguntas de investigación planteadas en el apartado 1.4, y no como un resumen de lo hecho.

## 5.1. Conclusiones

### 5.1.1. Sobre Los Requerimientos Del Riego Automático Y La Supervisión Del Nivel De Agua

Un sistema de riego gobernado por sensor capacitivo resulta técnicamente viable con componentes de mercado nacional, pero su dimensionamiento no puede apoyarse en los valores nominales declarados por los fabricantes. El cálculo del número de Reynolds situó el flujo del circuito hidráulico en régimen turbulento y no laminar, resultado que invalida el uso de la correlación simplificada del factor de fricción y que obliga a estimar las pérdidas de carga con la ecuación de Darcy-Weisbach acompañada de los coeficientes de pérdidas menores. Ese hallazgo, contrario a la suposición habitual en sistemas de bajo caudal, constituye la corrección de mayor consecuencia práctica del trabajo.

El requerimiento crítico de la etapa de potencia no es la corriente nominal de la bomba sino la compatibilidad de la tensión de puerta del transistor con los cinco voltios que entrega el microcontrolador. Un dispositivo que especifique su resistencia de conducción para diez voltios opera en conducción incompleta bajo esa excitación, con una disipación que crece de forma cuadrática con la corriente. Este requisito, que no aparece de forma explícita en la mayoría de los esquemas de referencia consultados, determina la selección del componente por encima de cualquier otro parámetro.

La medición de humedad solo adquiere significado tras una calibración experimental. La relación entre la señal del convertidor y el contenido volumétrico de agua depende del sustrato, de su salinidad y de su temperatura, de modo que las curvas del fabricante tienen validez limitada. Un ajuste de dos puntos entre aire y saturación resulta suficiente para el intervalo de trabajo, aunque la literatura consultada muestra que un ajuste polinómico mejora de forma apreciable la correspondencia en toda la escala.

Para un depósito de volumen reducido, el principio de flotación resulta superior a la medición de presión hidrostática. La presión manométrica en el fondo de una columna de doce centímetros apenas alcanza 1,18 kPa, magnitud que exigiría un transductor de alta resolución y una cadena de acondicionamiento elaborada para obtener una información que el sistema, en última instancia, solo necesita en forma binaria. Un flotador entrega esa condición directamente, sin calibración ni conversión de unidades.

La supervisión del nivel cumple una función de protección del actuador y no de información a la persona usuaria. Su incorporación como condición de habilitación en la operación booleana de la ecuación (22) impide que la bomba opere en seco, situación que degrada el diafragma fuera de su régimen elástico y que priva al motor de la refrigeración que el propio flujo le proporciona. Ninguno de los cuatro antecedentes revisados incorporaba esta condición, lo que sitúa el aporte del proyecto en ese punto concreto.

El acondicionamiento del contacto exige una resistencia de polarización y un tratamiento del rebote. Sin la primera, la entrada digital queda sin referencia definida mientras el contacto permanece abierto y el ruido del entorno basta para que la lectura oscile; sin el segundo, la transición mecánica produce cierres sucesivos que el programa interpretaría como eventos independientes.

### 5.1.2. Sobre Las Variables Ambientales Relevantes

La temperatura y la humedad relativa deben interpretarse de forma conjunta y no por separado, porque su acoplamiento físico se expresa en el déficit de presión de vapor y no en ninguna de las dos por sí sola. El cálculo mostró que un incremento de 22 °C a 30 °C con humedad relativa constante eleva ese déficit en un 61 %, resultado que explica por qué el sustrato pierde agua a velocidades muy distintas bajo condiciones que la lectura de humedad relativa presentaría como idénticas.

La iluminancia medida en lux constituye una referencia orientativa y no una medida de la radiación útil para la fotosíntesis. La conversión hacia la densidad de flujo fotónico depende de la distribución espectral de la fuente, de modo que dos ambientes con la misma lectura en lux pueden aportar cantidades muy distintas de radiación aprovechable. Esa limitación debe declararse de forma explícita para que la información presentada no se interprete como un diagnóstico.

Las tres variables cumplen función de monitoreo y ninguna de ellas interviene en la decisión de riego. Esa separación, adoptada de forma deliberada, mantiene simple la lógica de control y evita que una variación atmosférica transitoria altere el comportamiento del actuador. El índice de bienestar que las reúne constituye una propuesta de diseño del proyecto y no una medida fisiológica validada, condición que queda documentada junto con los pesos y los intervalos empleados.

### 5.1.3. Sobre La Arquitectura Funcional Integrada

La integración de los tres subsistemas sobre una sola plataforma resultó posible sin conflictos de recursos. El bus de dos hilos asignado al sensor de iluminancia dejó libres suficientes entradas analógicas y digitales para el resto de los componentes, y el firmware ocupa márgenes de memoria que dejan espacio para las ampliaciones previstas.

La separación entre el dominio de control y el de potencia constituye la decisión arquitectónica que más condiciona la fiabilidad del conjunto. Exige tres medidas simultáneas: la referencia común obligatoria entre ambas fuentes, el retorno de potencia separado hasta un punto único de unión, y el desacoplo local mediante condensador junto al punto de conexión de la carga. La omisión de cualquiera de ellas produce fallas intermitentes, difíciles de diagnosticar porque solo se manifiestan mientras el actuador está en marcha.

El costo total del prototipo asciende a unos 46 600 colones, equivalentes a 89,60 dólares estadounidenses, cifra que se sitúa por debajo de la reportada por los antecedentes revisados para sistemas de alcance comparable y que respalda cuantitativamente la afirmación de accesibilidad que sostiene la justificación del proyecto.

### 5.1.4. Sobre La Validación Del Prototipo

La simulación verificó la corrección de la lógica de control, de la topología del circuito y del funcionamiento de las protecciones, pero no sustituye la validación física. El entorno reproduce modelos idealizados que omiten las inductancias parásitas del cableado, la resistencia de contacto de las conexiones y el acoplamiento electromagnético entre conductores próximos, que son precisamente los fenómenos responsables de las fallas más frecuentes en montajes de este tipo.

Las sustituciones de componentes exigidas por el entorno —el módulo SIMULINO UNO por el Arduino Uno, la fotorresistencia por el BH1750 y el potenciómetro por el sensor capacitivo— conservan la lógica pero no la respuesta dinámica de los dispositivos reales. El cuarto objetivo específico se cumplió, por tanto, de forma parcial: quedó verificado el comportamiento del diseño y pendiente la comprobación del prototipo construido.

### 5.1.5. Conclusión General

La respuesta a la pregunta problema es afirmativa con reservas. Una maceta inteligente controlada por Arduino que integre el riego por humedad de suelo, la supervisión del nivel del tanque y el monitoreo ambiental es técnica y funcionalmente viable para entornos domésticos y educativos de Costa Rica, con un costo accesible y componentes de disponibilidad local. La reserva es metodológica y no técnica: la viabilidad quedó demostrada sobre un diseño verificado en simulación, no sobre un prototipo operando en condiciones reales, de manera que la afirmación se sostiene sobre el comportamiento previsto y no sobre el observado.

## 5.2. Recomendaciones

Las recomendaciones se dirigen a quienes retomen el desarrollo, y se ordenan según su urgencia para completar el trabajo antes que según su ambición técnica.

- Construir el prototipo físico y repetir la verificación de la Tabla 10 sobre el montaje real, prestando atención particular a la tensión entre puerta y fuente durante la conmutación y a la sobretensión efectiva sobre el transistor en el instante de apertura.
- Calibrar el sensor capacitivo mediante método gravimétrico normalizado, secando muestras de sustrato en horno y relacionando la masa perdida con la señal registrada, en lugar del ajuste de dos puntos entre aire y saturación previsto en el diseño.
- Medir el caudal efectivo de la bomba recogiendo el volumen descargado en un intervalo cronometrado, y contrastarlo con el valor nominal declarado. Ese dato corrige de forma directa el volumen entregado por evento y la autonomía calculada del depósito.
- Verificar experimentalmente la constante de tiempo del sustrato registrando la caída de humedad entre riegos, y comprobar su dependencia del déficit de presión de vapor. El valor de 120 horas empleado en los cálculos es una estimación de diseño que no se apoya en medición propia.
- Diseñar y construir la etapa de alimentación, incluyendo la rectificación y el filtrado, dado que las fuentes ideales de la simulación no reproducen el rizado de 120 Hz analizado en el marco teórico. Verificar que ese rizado no alcance la referencia del circuito de medición.
- Documentar los intervalos y los pesos del índice de bienestar para la especie concreta empleada, y no adoptar los valores genéricos de la Tabla 4 sin revisión, porque su elección determina por completo la valoración presentada.
- Incorporar el registro histórico de las variables antes que cualquier otra ampliación, porque sin series temporales prolongadas no es posible evaluar el desempeño del sistema ni justificar la migración hacia estrategias de control más elaboradas.
- Repetir la validación con más de una unidad operando en paralelo, condición necesaria para separar el comportamiento del diseño del comportamiento del ejemplar concreto construido.

# Referencias

Behera, B., Borole, U. P., Gawade, T. C., Khan, J., Barshilia, H. C. y Chowdhury, P. (2023). Design and development of submersible hydrostatic level sensor using a GMR sensor. Measurement, 206, 112310. https://doi.org/10.1016/j.measurement.2022.112310

Bierer, A. M. (2023). Development of an open-source soil water potential management system for horticultural applications, "Open_Irr". HardwareX, 15, e00458. https://doi.org/10.1016/j.ohx.2023.e00458

Boylestad, R. L. y Nashelsky, L. (2009). Electrónica: teoría de circuitos y dispositivos electrónicos (10.ª ed.). Pearson Educación.

Campos, H. M., Oliveira, H. F. E., Mesquita, M., Castro, L. E. V. y Ferrarezi, R. S. (2021). Low-cost open-source platform for irrigation automation. Computers and Electronics in Agriculture, 190, 106481. https://doi.org/10.1016/j.compag.2021.106481

Cengel, Y. A. y Cimbala, J. M. (2006). Mecánica de fluidos: fundamentos y aplicaciones (1.ª ed.). McGraw-Hill.

Cherif, I., Cherqui, F., Perret, F., Bourjaillat, B., Lord, L., Bertrand-Krajewski, J. L., Walcker, N., Gisi, M., Bacot, L. y Navratil, O. (2025). LevelWAN: A cost-effective, open-source IoT system for water level monitoring in highly dynamic aquatic environments. HardwareX, 23, e00685. https://doi.org/10.1016/j.ohx.2025.e00685

Deng, X., Yang, L., Fu, Z., Du, C., Lyu, H., Cui, L., Zhang, L., Zhang, J. y Jia, B. (2021). A calibration-free capacitive moisture detection method for multiple soil environments. Measurement, 173, 108599. https://doi.org/10.1016/j.measurement.2020.108599

Gao, H., Mo, Y., Wang, J., Wu, F., Gao, N. y Gong, S. (2023). Model for predicting the hydraulic elements of drip irrigation system with automatic flushing valves under high sediment water. Biosystems Engineering, 228, 18–30. https://doi.org/10.1016/j.biosystemseng.2023.02.007

Hibbeler, R. C. (2011). Mecánica de materiales (8.ª ed.). Pearson Educación.

Hou, P., Ma, C., Wang, J., Li, Y., Zhang, K., Hou, S., Li, J., Sun, Z., Xiao, Y. y Li, Y. (2024). Failure behavior of pressure compensating emitter under different operation pressures in drip irrigation systems. Agricultural Water Management, 297, 108835. https://doi.org/10.1016/j.agwat.2024.108835

Hu, X., Zhao, K., Hu, C. y Li, Y. (2026). Investigation of a diaphragm-valve adaptive piezoelectric stack pump with a conical plug valve structure. Results in Engineering, 29, 109196. https://doi.org/10.1016/j.rineng.2026.109196

Ikram, M., Ameer, S., Kulsoom, F., Sher, M., Ahmad, A., Zahid, A. y Chang, Y. (2024). Flexible temperature and humidity sensors of plants for precision agriculture: Current challenges and future roadmap. Computers and Electronics in Agriculture, 226, 109449. https://doi.org/10.1016/j.compag.2024.109449

Jain, R. K. (2023). Experimental performance of smart IoT-enabled drip irrigation system using and controlled through web-based applications. Smart Agricultural Technology, 4, 100215. https://doi.org/10.1016/j.atech.2023.100215

Jiménez, I. J. (2025). Automatización del riego en un invernadero para cultivo de hortalizas de traspatio. Latam: Revista Latinoamericana de Ciencias Sociales y Humanidades, 6(4), 1–17.

Jin, W., Ji, Y., Larsen, D. H., Huang, Y., Heuvelink, E. y Marcelis, L. F. M. (2023). Gradually increasing light intensity during the growth period increases dry weight production compared to constant or gradually decreasing light intensity in lettuce. Scientia Horticulturae, 311, 111807. https://doi.org/10.1016/j.scienta.2022.111807

Li, L. y Masen, M. (2024). A new method for determining the Ogden parameters of soft materials using indentation experiments. Journal of the Mechanical Behavior of Biomedical Materials, 155, 106574. https://doi.org/10.1016/j.jmbbm.2024.106574

Li, P., Liu, C., Tong, X., Li, X. y Zheng, G. (2025). Improved direct ripple power predictive control of single-phase rectifier based on ripple separation. Control Engineering Practice, 155, 106173. https://doi.org/10.1016/j.conengprac.2024.106173

Liu, P., Fan, Y., Zhang, Y. G. y Ze, S. (2023). AC/DC side split capacitor power decoupling circuit. Journal of Electrical Engineering & Technology, 18, 2801–2810. https://doi.org/10.1007/s42835-022-01364-0

Mohith, S., Karanth, P. N. y Kulkarni, S. M. (2022). Analysis of annularly excited bossed diaphragm for performance enhancement of mechanical micropump. Sensors and Actuators A: Physical, 335, 113381. https://doi.org/10.1016/j.sna.2022.113381

Pahuja, R. (2022). Development of semi-automatic recalibration system and curve-fit models for smart soil moisture sensor. Measurement, 203, 111907. https://doi.org/10.1016/j.measurement.2022.111907

Pearce, R. H., Chadwick, M. A., Main, B., Chan, K., Sayer, C. D. y Patmore, I. R. (2024). Low-cost approach to an instream water depth sensor construction using differential pressure sensors and Arduino microcontrollers. Sensors, 24(8), 2488. https://doi.org/10.3390/s24082488

Potosí Carvajal, C. A., Jinez Cedeño, B. A. y Tapia Gaibor, C. R. (2024). Sistema de tiempo real para el riego en la finca "Carmen Torres". Revista Ciencia UNEMI, 17(44), 1–14. https://doi.org/10.29076/issn.2528-7737vol17iss44.2024pp01-14p

Pramanik, M., Khanna, M., Singh, M., Singh, D. K., Sudhishri, S., Bhatia, A. y Ranjan, R. (2022). Automation of soil moisture sensor-based basin irrigation system. Smart Agricultural Technology, 2, 100032. https://doi.org/10.1016/j.atech.2021.100032

Qu, C., Sun, W., Hu, D., Yang, C., Zhao, T., Wang, X. y He, Z. (2024). Semi-embedded flexible multifunctional sensor for on-site continuous monitoring of plant microclimate. Computers and Electronics in Agriculture, 216, 108521. https://doi.org/10.1016/j.compag.2023.108521

Sedra, A. S. y Smith, K. C. (2015). Microelectronic circuits (7.ª ed.). Oxford University Press.

Setiawan, Y. D., Hartanto, W., Lukas, E. E., Julienne, N. D. B., Kurniawan, S. y Siswanto, B. (2023). Smart plant watering and lighting system to enhance plant growth using Internet of Things. Procedia Computer Science, 227, 966–972. https://doi.org/10.1016/j.procs.2023.10.604

Sugano, S., Ishii, M. y Tanabe, S. I. (2024). Adaptation of indoor ornamental plants to various lighting levels in growth chambers simulating workplace environments. Scientific Reports, 14, 17424. https://doi.org/10.1038/s41598-024-67877-y

Sundararaj, S., Krishnakumar, P., Anirudh, V. R., Shikhar, L. C., Surendhar, G. y Vijay, V. (2022). Effect of water pressure and temperature on spherical float of level sensing auto drain valve. Materials Today: Proceedings, 49(5), 1490–1497. https://doi.org/10.1016/j.matpr.2021.07.235

Tippens, P. E. (2009). Física: conceptos y aplicaciones (7.ª ed.). McGraw-Hill.

Tripathi, D., Bhandari, D. S. y Bég, O. A. (2023). A critical review of micro-scale pumping based on insect-inspired membrane kinematics. Sensors and Actuators A: Physical, 360, 114518. https://doi.org/10.1016/j.sna.2023.114518

Verma, S. y Pahuja, R. (2021). Recalibration and performance comparison of soil moisture sensors using regression and neural network characteristic models. Materials Today: Proceedings, 45(6), 4852–4861. https://doi.org/10.1016/j.matpr.2021.01.306

Xu, T., Su, Y., Su, Z., Zhi, S., Zheng, E. y Yan, C. (2022). Simulation of the hydraulic behavior of a bionic-structure drip irrigation emitter. Fluid Dynamics and Materials Processing, 18(4), 1169–1182. https://doi.org/10.32604/fdmp.2022.018628

Zaccarin, A. M., Peddada, N., Machold, M., Turner, K. T. y Olsson, R. H. (2025). Inductively coupled capacitive soil moisture sensors printed on a biodegradable substrate: Characterization and long-term testing. Smart Agricultural Technology, 11, 101052. https://doi.org/10.1016/j.atech.2025.101052

Zhang, J., Wang, Z. y Yang, X. (2026). Constructing an interconnected gel with ionic fluid channels for AC line-filtering. Chemical Science, 17, 11496–11503. https://doi.org/10.1039/D6SC02703B

Zhao, Q., Zhang, G., Yang, S. y Li, Y. (2025). Supercapacitors with precision ordered structure electrodes for AC line filtering. Journal of Energy Storage, 108, 115028. https://doi.org/10.1016/j.est.2024.115028

Zill, D. G. (2018). Ecuaciones diferenciales con aplicaciones de modelado (11.ª ed.). Cengage Learning.

# Anexos

## Anexo A. Ficha De Registro Técnico De Componentes

Instrumento asociado a la técnica de análisis documental descrita en el apartado 3.1.3.1. Se resumen las especificaciones de cada componente del prototipo.

Tabla A1

Ficha de registro técnico de componentes

Componente | Función | Alimentación | Corriente | Intervalo y exactitud | Salida o interfaz | Observaciones
Arduino Uno (ATmega328P) | Controlador principal | 5 V (7-12 V por conector) | 20 mA por pin (máx. 40 mA) | ADC 10 bits, 0-5 V; ±2 LSB | E/S digitales, analógicas, I2C, UART | Lógica de 5 V compatible con todos los módulos
Sensor capacitivo AD69070 | Humedad del suelo | 3,3-5,5 V | ~5 mA | 0-100 % relativo por calibración; no declarada | Analógica | Requiere calibración seco/saturado
Flotador AD12343 (N.C.) | Nivel mínimo de agua | Pull-up interno 5 V | < 1 mA | Dos estados; no aplica | Digital (contacto seco) | Verificar polaridad antes de conectar la bomba
DHT22 (AM2302) | Temperatura y humedad del aire | 3,3-6 V | 1-1,5 mA | -40 a 80 °C ±0,5 °C; 0-100 % HR ±2 % | Digital un hilo | Lectura cada 2 s; pull-up de 4,7 kΩ
BH1750FVI | Iluminancia | 3-5 V (módulo) | 120 µA | 1-65 535 lx; ±20 % | I2C (0x23) | Conectado en A4/A5
Bomba de diafragma | Riego del sustrato | 6-12 V DC | 400 mA (pico 900 mA al arranque) | No aplica | Conmutada por MOSFET | Se activa con suelo seco y agua disponible
MOSFET IRLZ44N | Conmutación de la bomba | VDS máx. 55 V | 47 A continua | VGS(th) 1-2 V; RDS(on) 0,025 Ω a 5 V | Interruptor de lado bajo | Nivel lógico; conduce plenamente con los 5 V del pin
Diodo 1N4007 | Rueda libre de la bomba | 1000 V inversa | 1 A (pico 30 A) | VF 1,1 V a 1 A | Pasivo en antiparalelo | Protege al MOSFET
Fuente AC-DC | Alimentación general | 100-240 V AC / 12 V DC | 2 A (24 W) | No declarada | Bornes DC | Alimenta bomba y regulador
Módulo LM2596 | Reducción de 12 V a 5 V | Entrada 4,5-40 V | Hasta 3 A | Salida ajustable; ±4 % | DC regulada | Ajustar a 5 V antes de conectar
Capacitor 100 µF / 25 V | Filtrado de alimentación | 25 V máx. | No aplica | ±20 % | Pasivo polarizado | Respetar polaridad

Nota. Elaboración propia a partir de las hojas de datos de los fabricantes y especificaciones de los distribuidores.

## Anexo B. Cuestionario Aplicado A Las Personas Consultadas

Instrumento asociado a la técnica de encuesta descrita en el apartado 3.1.3.1.

- ¿Con qué frecuencia riega sus plantas de interior y cómo decide cuándo hacerlo?
- ¿Ha perdido alguna planta por exceso o por falta de riego? ¿A qué lo atribuye?
- ¿Cuánto tiempo dedica por semana al cuidado de sus plantas?
- ¿Sabe si sus plantas reciben suficiente luz? ¿Cómo lo determina?
- De las tres funciones automatizadas propuestas —riego por humedad, aviso de tanque vacío y monitoreo ambiental—, ¿cuál le resultaría más útil y por qué?
- ¿Preferiría consultar la información de las variables ambientales de manera local en el dispositivo o desde el teléfono?
- ¿Qué precio consideraría razonable por un dispositivo con estas funciones?

## Anexo C. Registro De La Verificación En Simulación

La Tabla 10 del apartado 4.5 constituye el instrumento de registro de la verificación funcional. Se recomienda acompañarla con una captura de pantalla del simulador por cada condición ensayada, en la que quede visible el estado de la salida de control y de la carga.

## Anexo D. Código Fuente Del Firmware

Programa desarrollado para el Arduino Uno. Las constantes de calibración corresponden a valores preliminares que deben ajustarse tras el procedimiento descrito en el apartado 2.1.2.

#include <Wire.h>

#include <BH1750.h>

#include <DHT.h>

// ---------- Asignación de terminales (ver Tabla 6) ----------

const uint8_t PIN_SUELO = A0; // sensor capacitivo

const uint8_t PIN_FLOTA = 2; // flotador, entrada con pull-up

const uint8_t PIN_DHT = 4; // DHT22

const uint8_t PIN_BOMBA = 6; // puerta del MOSFET Q1

const uint8_t PIN_MODO = 7; // interruptor SW1

// ---------- Calibración del sensor capacitivo, ec. (13) ----------

const int S_AIRE = 620; // lectura en aire

const int S_SAT = 285; // lectura en sustrato saturado

const float THETA_SAT = 0.55; // contenido volumétrico a saturación

// ---------- Umbrales de control, ec. (18) ----------

const float THETA_ON = 0.40; // activa la bomba

const float THETA_OFF = 0.55; // detiene la bomba (histéresis)

const unsigned long T_MIN_EVENTOS = 3600000UL; // 1 h entre riegos

const unsigned long T_BOMBA_MAX = 8000UL; // duración máx. del riego

const unsigned long T_CICLO = 2000UL; // período del ciclo

// ---------- Intervalos del índice IBV, ec. (31) y (32) ----------

const float T_MIN = 15.0, T_MAX = 30.0, W_T = 0.25;

const float H_MIN = 60.0, H_MAX = 80.0, W_H = 0.20;

const float L_MIN = 1000.0, L_MAX = 10000.0, W_L = 0.15;

const float W_S = 0.40; // peso de la humedad de suelo

DHT dht(PIN_DHT, DHT22);

BH1750 luxMetro;

bool bombaEncendida = false;

unsigned long tUltimoRiego = 0, tInicioRiego = 0, tUltimoCiclo = 0;

// Promedia n lecturas del convertidor A/D (apartado 2.5.4)

int leerPromedio(uint8_t pin, uint8_t n) {

long acum = 0;

for (uint8_t i = 0; i < n; i++) { acum += analogRead(pin); delay(5); }

return (int)(acum / n);

}

// Convierte la lectura cruda a contenido volumétrico, ec. (13)

float aHumedadVolumetrica(int s) {

float theta = (float)(S_AIRE - s) / (float)(S_AIRE - S_SAT) * THETA_SAT;

return constrain(theta, 0.0, THETA_SAT);

}

// Indicador parcial: 1 si la variable cae dentro del intervalo, ec. (31)

float dentroDe(float x, float minimo, float maximo) {

return (x >= minimo && x <= maximo) ? 1.0 : 0.0;

}

void setup() {

pinMode(PIN_BOMBA, OUTPUT);

digitalWrite(PIN_BOMBA, LOW); // estado seguro al arrancar

pinMode(PIN_FLOTA, INPUT_PULLUP); // resistencia de polarización

pinMode(PIN_MODO, INPUT_PULLUP);

Wire.begin();

dht.begin();

luxMetro.begin();

}

void loop() {

unsigned long ahora = millis();

// Corte de seguridad: limita la duración de cada evento de riego

if (bombaEncendida && (ahora - tInicioRiego >= T_BOMBA_MAX)) {

digitalWrite(PIN_BOMBA, LOW);

bombaEncendida = false;

tUltimoRiego = ahora;

}

if (ahora - tUltimoCiclo < T_CICLO) return;

tUltimoCiclo = ahora;

// --- Lectura de sensores ---

float theta = aHumedadVolumetrica(leerPromedio(PIN_SUELO, 8));

float tempC = dht.readTemperature();

float hrPct = dht.readHumidity();

float luxes = luxMetro.readLightLevel();

bool hayAgua = (digitalRead(PIN_FLOTA) == LOW); // contacto cerrado

bool modoAuto = (digitalRead(PIN_MODO) == LOW);

if (isnan(tempC) || isnan(hrPct)) { tempC = -99; hrPct = -99; }

// --- Índice de bienestar vegetal, ec. (32) ---

float ibv = W_S * dentroDe(theta * 100.0, 40.0, 70.0)

+ W_T * dentroDe(tempC, T_MIN, T_MAX)

+ W_H * dentroDe(hrPct, H_MIN, H_MAX)

+ W_L * dentroDe(luxes, L_MIN, L_MAX);

if (!hayAgua) {

} else {

}

// --- Lógica de riego: B = H AND N AND T, ec. (22) ---

if (!modoAuto) { digitalWrite(PIN_BOMBA, LOW); bombaEncendida = false; return; }

if (!bombaEncendida) {

bool suelenSeco = (theta < THETA_ON);

bool tiempoOk = (tUltimoRiego == 0) || (ahora - tUltimoRiego >= T_MIN_EVENTOS);

if (suelenSeco && hayAgua && tiempoOk) {

digitalWrite(PIN_BOMBA, HIGH);

bombaEncendida = true;

tInicioRiego = ahora;

}

} else {

// Histéresis: detiene en THETA_OFF, no en THETA_ON

if (theta >= THETA_OFF || !hayAgua) {

digitalWrite(PIN_BOMBA, LOW);

bombaEncendida = false;

tUltimoRiego = ahora;

}

}

}

Nota. El código emplea temporización no bloqueante mediante millis() en lugar de delay(), de modo que la adquisición de sensores continúa durante el intervalo de espera entre eventos. La inversión lógica del flotador (contacto cerrado equivale a nivel bajo) responde al uso de la resistencia de polarización interna descrita en el apartado 2.2.3.

## Anexo E. Planos Y Archivos De Manufactura

Las vistas acotadas de la carcasa se presentan en la Figura 2 del apartado 3.3. Los archivos de modelado tridimensional para manufactura aditiva se entregan por separado e incluyen el cuerpo hexagonal, la tapa del depósito y los soportes de sensores. Los parámetros de impresión recomendados son altura de capa de 0,2 mm, relleno del 25 % y tres perímetros, valores que ofrecen rigidez suficiente para la carga estimada en el apartado 2.6.3 sin extender en exceso el tiempo de fabricación.

# Declaración De Uso De Inteligencia Artificial

En cumplimiento de las consideraciones éticas establecidas en la Guía Oficial de la Licenciatura en Ingeniería Mecatrónica de la Universidad INVENIO, se declara que en la elaboración del presente Proyecto Final se empleó un sistema de inteligencia artificial generativa como herramienta de apoyo. Su uso se circunscribió a la revisión de la redacción y del estilo académico, al control del formato de citación conforme a la séptima edición de las normas de la Asociación Estadounidense de Psicología, a la verificación de la extensión de los párrafos, a la organización estructural del documento y a la detección de inconsistencias internas entre secciones.

Se declara asimismo que la herramienta no se utilizó para generar los datos técnicos del prototipo, los cuales provienen de las hojas de datos de los fabricantes y de la simulación realizada por el equipo, ni para producir las referencias bibliográficas, las cuales fueron localizadas y contrastadas de manera directa en los repositorios institucionales y en las bases de datos académicas correspondientes. La responsabilidad sobre el contenido, sobre la interpretación de las fuentes, sobre los cálculos presentados y sobre las conclusiones recae íntegramente en las personas autoras, quienes revisaron y validaron cada aporte de la herramienta antes de incorporarlo al documento.
