Kronnos2006/smart-plant-bot/biblotecas.ino

/*
 * biblotecas.ino - Smart Plant Bot
 *
 * Archivo ancla del sketch. El Arduino IDE exige que exista un .ino con
 * el mismo nombre que la carpeta que lo contiene; este archivo cumple
 * esa funcion y no contiene codigo.
 *
 * El firmware real esta en protocolo_serial.ino, que es el unico que
 * define setup() y loop(). El IDE concatena todos los .ino de la
 * carpeta en un solo programa, asi que no hay que incluir nada aqui.
 *
 * Si se clona el repositorio, la carpeta se va a llamar smart-plant-bot:
 * renombrar la carpeta a smart_plant_bot (guion bajo, no guion medio) y
 * este archivo a smart_plant_bot.ino para que el IDE la abra.
 */
