Kronnos2006/smart-plant-bot/(commit log)

2026-09-23 Biblioteca de perfiles: 6 especies nuevas (violeta africana + 5 de casa tica)
    Agrega Violeta africana, Lengua de suegra, Helecho de Boston, Orquidea
    mariposa, Culantro coyote y Chile dulce a datos/plantas.csv, regenera
    plantas.cpp y sube NUM_PERFILES de 8 a 14.
    Culantro coyote y Chile dulce entran con fuente verificada (literatura
    costarricense, Agronomia Costarricense). Las otras cuatro quedan como
    negativos confirmados: se busco fuente academica con umbral de humedad
    de sustrato y no existe para esas especies.
    Claude-Session: https://claude.ai/code/session_01L4cGvhc9Vpzdkx5r4KL3Hq
    [plantas.csv]
2026-09-23 README: agrega guia de puesta en marcha paso a paso
    Explica que el Arduino no detecta la especie: el perfil se elige por
    Serial con SELECT y queda en EEPROM. Cubre cargar el firmware, LISTAR
    con la tabla de indices, la calibracion obligatoria, SELECT, la
    verificacion con ESTADO y la prueba con RIEGO;MANUAL.
    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
2026-09-23 Agrega biblotecas.ino y documenta la carga al Arduino paso a paso
    El IDE exige un .ino con el nombre de la carpeta y no existia, asi que
    el sketch no abria. biblotecas.ino es un ancla sin codigo.
    El README ahora cubre instalar DHT sensor library y BH1750, abrir el
    sketch, elegir placa y puerto, verificar, subir y configurar el Monitor
    Serial a 9600 con final de linea Nueva linea, con los errores tipicos.
    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
    [biblotecas.ino]
2026-09-23 Alinea los pines del firmware al cableado real del equipo
    Bomba 5->7, flotador 6->3, DHT22 7->2, segun el sketch de prueba ya
    verificado en protoboard. El flotador pasa a INPUT_PULLUP, que es como
    esta cableado (HIGH en reposo, LOW al cerrar contra GND); NIVEL_AGUA_OK
    se mantiene en HIGH y ahora el comentario explica por que.
    El README suma una tabla de cableado y una advertencia: CAL;SECO va con
    el sensor al aire y CAL;AGUA sumergido, no con el sensor en tierra, o
    el rango queda bajo las 100 cuentas que exige configEstaCalibrada() y
    el riego automatico queda inhibido sin aviso claro.
    Claude-Session: https://claude.ai/code/session_01L4c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
2026-09-24 Agrega dos sketches de ejemplo: modo manual y perfil violeta africana
    ejemplos/modo_manual/ es diagnostico de hardware: no riega solo, la
    bomba se controla con 1 y 0 desde el Monitor Serial mientras imprime
    todos los sensores. Lee el BH1750 por I2C directo con Wire, sin depender
    de la libreria BH1750.
    ejemplos/violeta_africana/ es el firmware minimo de un solo perfil
    (45 %, dosis 5 s, espera 24 h) sobre la calibracion 350/280 ya medida.
    La bomba corta al instante si el flotador cae durante el riego y tiene
    un tope duro de 10 s.
    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
2026-11-08 Agrega documentos de la entrega final: informe y presentaciones
    Claude-Session: https://claude.ai/code/session_012PbMNnR5Dp3GH6s4VjrE5T
2026-11-08 Reorganiza el repositorio por carpetas y agrega README principal
    - firmware/smart_plant_bot/: sketch principal; biblotecas.ino pasa a
    smart_plant_bot.ino para que abra sin renombrar al clonar
    - firmware/ejemplos/: sketches de prueba
    - herramientas/: csv_a_header.py (rutas actualizadas) y puente_serial.py
    - web/: plantabot.html
    - docs/MANUAL.md: manual tecnico (antes README.md), rutas actualizadas
    - README.md nuevo con estructura, hardware, pines, logica y arranque
    - Elimina 'Claude outputs/' (duplicado de ejemplos/violeta_africana)
    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
